Georgia-Tech-Off-Road/GTOR-DAQ/README.md

# GTOR-DAQ-Documentation
DAQ stuff! #rtfm
Main repository for Georgia Tech Offroad Data Aquisition ("GTOR DAQ").
