Georgia-Tech-Off-Road/GTOR-DAQ/Guides/SoftwareProposal.md

# New Software Proposal Form

# Software Details

## Overview

**Software Name:**

**Software Acronym:**

**Software Type (Utility/Library):**

## Goals
What are the objectives of this software? What will you do?

# Stages
Try to layout the development of this software as a series of projects. When/if this section is modified add the date of the modified stage as such:
Implement Fundemental System (rev. 06/23/2025)
