Georgia-Tech-Off-Road/GTOR-DAQ/01 New Member Information/09-25-2025 DAQ Meeting.pptx

## DAQ Meeting

## Agenda

- ADCs
- Strain Gauges
- PCB Design
- Testing
- Scripting Deployment
- Car wiring

## The Power of

Communication

## Overcoming

Nervousness

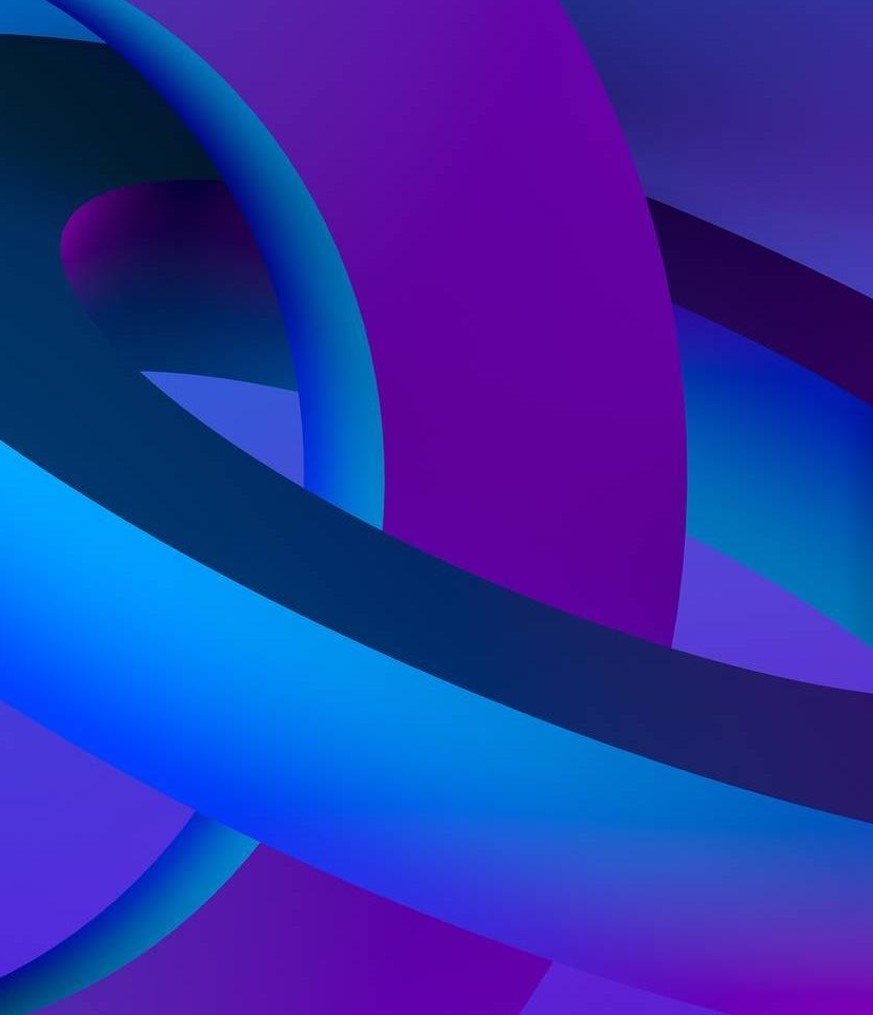
[picture p1: figure]
A blue and purple spirals

## Joseph & Colin

- sensor testing and validation

## Glenn & Kyle

Altium PCB design
- 1256 board, 2DREV12025

## Andrew

Strain Gauges / 1256 / PCB Design

## Alaric

1256 / Website / Test Class

## Dhruvith

Strain Gauges / Car Wiring

## DeadLines

Testing Class
- Tuesday 09/30/2025
Sensor Testing
- All hall effects and RPMs tested by 10/09/2025
1256 ADC
- Data recording by 10/02/2025
PCB Design Rev12025
- Rough draft 10/09/2025
- Use live polls or surveys to gather audience opinions, promoting engagement and making sure the audience feel involved

## DeadLines

PCB Design 1256 Board
- Rough draft 10/09/2025
Strain Gauges
- Have an operational strain gauge 10/09/2025

## SELECTING VISUAL AIDS

ENHANCING YOUR PRESENTATION

## Challenges

Time synchronization w Can / Data-Saving
Time Synchronization W XBees
Stable Voltage Supply
