Georgia-Tech-Off-Road/GTOR-DAQ/04 Sensors/Strain Gauge/Strain_Gauges.docx

# Strain Gauges

GT Off-Road Racing | Data Acquisition

Andrew Hellrigel

09/12/2021

# 1.0 Overview

## 1.1 Introduction

## 1.2 Point of Contact

Andrew Hellrigel (ahellrigel3@gatech.edu): Designed PCB for load cells

# 2.0 Strain Gauges

## 2.1 Strain Gauge Background

A strain gauge is an electromechanical device that changes in resistance when a strain is applied. When an external force is applied on an object, strain (tensile/compressive deformation in the shape of the object) occurs. Strain is defined as the change in length divided by the original length.

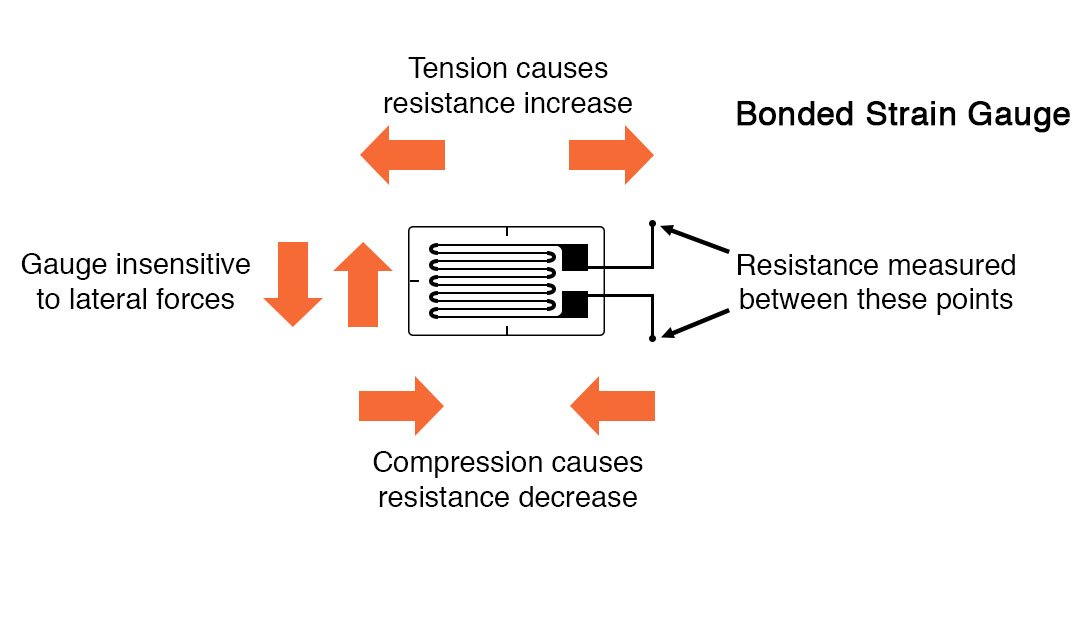
[picture p2: figure]
bonded strain gauge
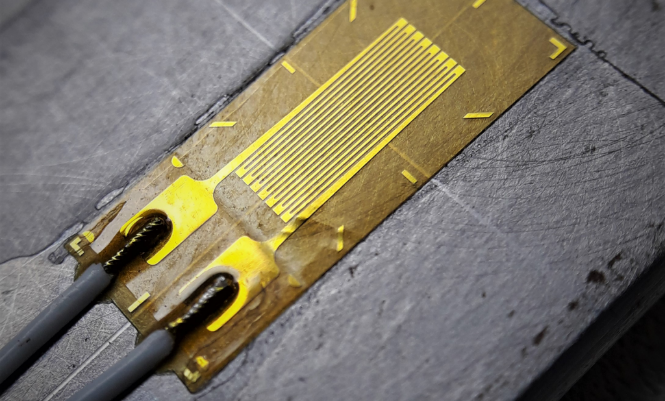
[picture p3: figure]
What is a Strain Gauge and How Does it Work? • Michigan Scientific

Figure 1 Forces measured by strain gauge | Figure 2 Strain gauge bonded to a test specimen

A strain gauges can be bonded to a test specimen (e.g. chassis tube). When the mechanical element has a force applied, the resulting strain can be measured at a specific point on the mechanical element.

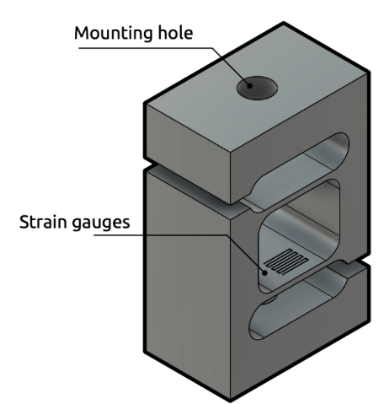
[picture p4: figure]
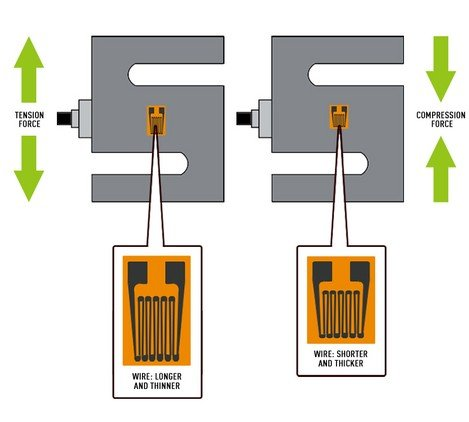
[picture p5: figure]
How Does a Strain Gauge Load Cell Work? | Load Cell Central
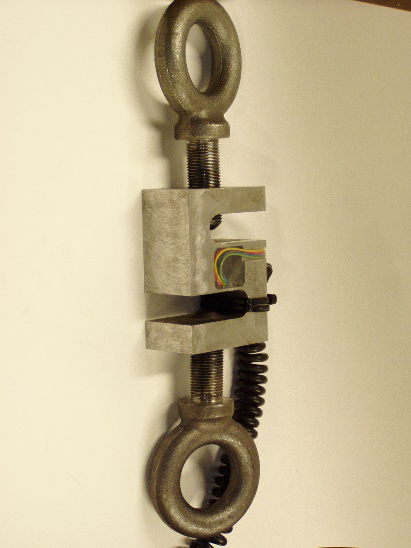
[picture p6: figure]
Load Cell Amplifier HX711 Breakout Hookup Guide - learn.sparkfun.com

Figure 3 S-type load cell 3D model | Figure 4 Forces measured by S-type load cell | Figure 5 S-type load cell mounted

A load cell is a transducer that measures force, and outputs this force as an electrical signal. For example, the S-type load cell pictured above measures tension and compression forces and can be mounted using the two threaded mounting holes on the top and bottom horizontals of the S.

# 3.0 Wheatstone Bridge

## 3.1 Wheatstone Bridge Circuit

### 3.1.1 Circuit Derivation

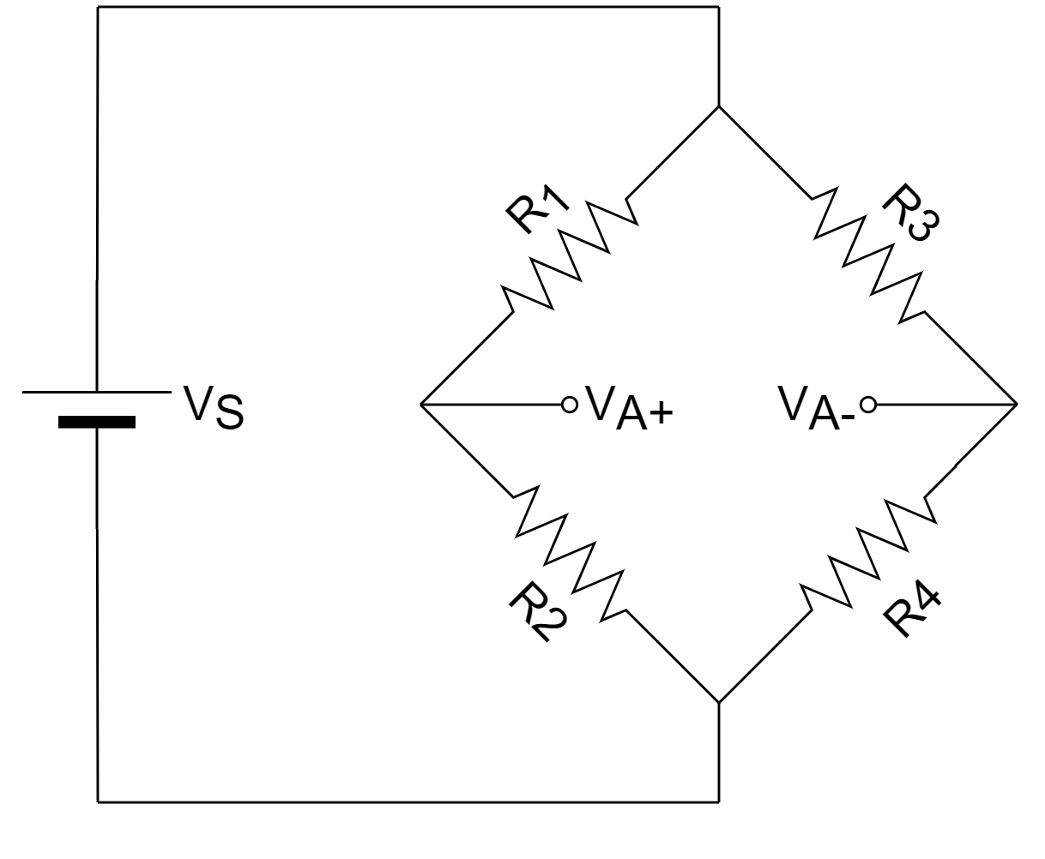
[picture p7: figure]

Figure 6 Wheatstone Bridge Circuit

A Wheatstone bridge is comprised of two voltage dividers in parallel. As such, the formulae for the node voltages are as follows:

V_(A+) =V_S *(R_1)/(R_1 +R_2) V_(A-) =V_S *(R_4)/(R_3 +R_4) V_(out) =V_(A+) -V_(A-)

V_(A+) and V_(A-) are derived from the voltage divider formula. V_(out) is the voltage difference between the A+ and A- nodes. V_(out) is proportional to the resistance variation of the resistors, R1, R2, R3, and R4. For example, if R1=R2=R3=R4, then VA+=VA-. As a result, Vout = 0. When the value of any resistor is changed, then the voltage difference Vout will change.

### 3.1.2 Swapping Resistors For Strain Gauges

The components for R1, R2, R3, and R4 can be normal resistors, or can be selectively replaced by a strain gauge (variable resistor based on strain). Using a strain gauge will allow Vout to increase/decrease based on the amount of strain on the test specimen.

## 3.2 Wheatstone Bridge Configurations

Table 1 Wheatstone Bridge Configurations

Configuration | Number of strain gauges | Number of resistors
Quarter-bridge | 1 | 3
Half-bridge | 2 | 2
Full-bridge | 4 | 0

### 3.2.1 Quarter-Bridge Strain Gauge Input

A quarter bridge strain gauge input is the simplest configuration that can be used. The resistive strain gauge is attached to the inputs on connector J1 to pins 5V and A+, and R1 is omitted from the PCB assembly. R2-R4 will be added to the PCB to complete the strain gauge.

### 3.2.2 Half-Bridge Strain Gauge Input

A half bridge strain gauge can also be connected to this circuit. The main advantage of a half-bridge strain gauges is that it compensates for changes in temperature.

### 3.2.3 Full-Bridge Strain Gauge Input

By omitting R1-R4, a full-bridge strain gauge can be connected directly to this circuit (this is the case for standard load cells that buy from Omega).

https://www.transducertechniques.com/wheatstone-bridge.aspx

# 4.0 Hardware Reference

## 4.1 Schematic (Input)

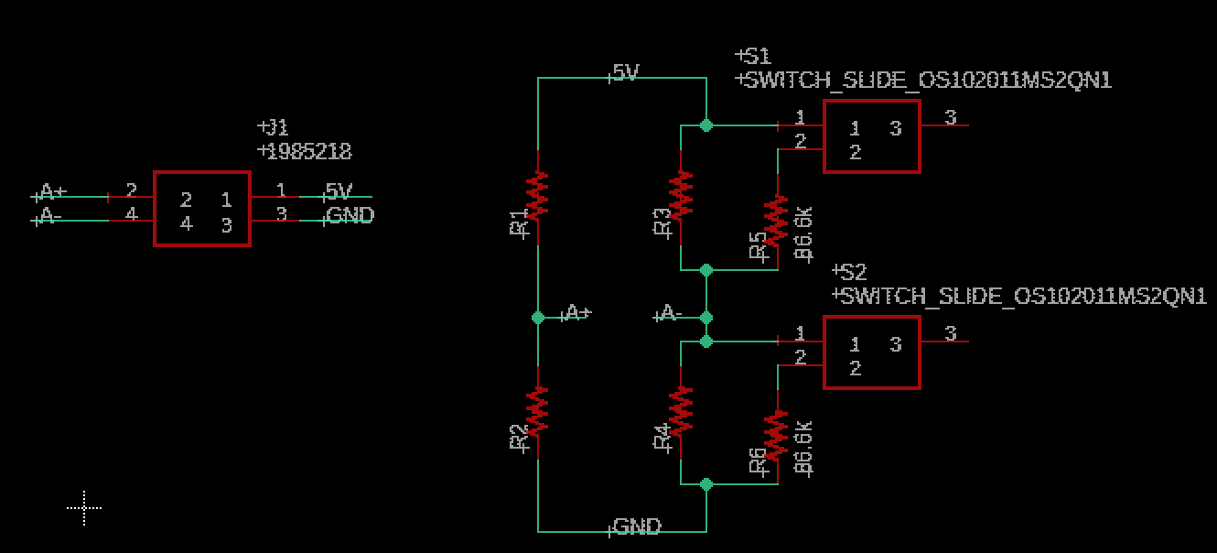
[picture p8: figure]

Figure 7

The above section of the schematic is the input along with the Wheatstone bridge. A Wheatstone bridge is a circuit that converts a change in resistance to a differential change in voltage between A+ and A-. R1-R4 are the bridge completion resistors.

### 4.1.1 Quarter-Bridge Strain Gauge Configuration

Attach a resistive strain gauge to the input pins, 5V and A+, on connector J1 to pins 5V and A+, and R1 is omitted from the PCB assembly. R2-R4 will be added to the PCB to complete the strain gauge.

### 4.1.2 Half-Bridge Strain Gauge Configuration

A half bridge strain gauge can also be connected to this circuit. The main advantage of a half-bridge strain gauges is that it compensates for changes in temperature.

### 4.1.3 Full-Bridge Strain Gauge Configuration

By omitting R1-R4, a full-bridge strain gauge can be connected directly to this circuit (this is the case for standard load cells that buy from Omega).

### 4.1.4 Output Signal Gain

R9 is the gain setting resistor for the amplifier. This resistor used should be as exact as possible. However, fi that’s not possible, use a higher resistance as opposed to a lower resistance if the difference is equal.

### 4.1.5 Calibration

R5-R6 are calibration resistors. When the slide switches are activated, they create a parallel voltage divider, decreasing the resistance of either R3 or R4 by a small amount. This, in effect, is emulating a change in resistance due to measured strain, however the exact change in resistance will be known. The actual change in measured strain can be divided against the expected change in measured strain to find a calibration factor that will calibrate against and variances in the tolerances of the electrical components used. Since there are two calibration resistors, this process can be done in both tension and compression.

This method of calibration is called shunt calibration, and this video does a decent job of explaining what that is. https://www.youtube.com/watch?v=w3RPWzUlq_Y

## 4.2 Schematic (Output)

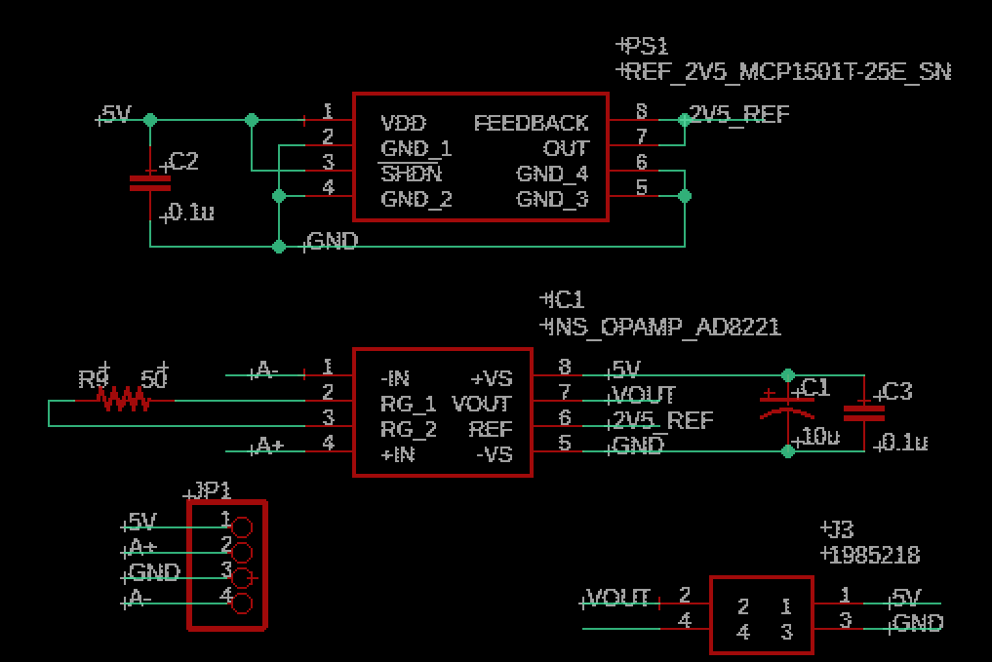
[picture p9: figure]

Figure 8

This portion of the schematic is the output section. It includes a voltage reference along with an instrumentation amplifier for amplifying the differential voltage generated by the Wheatstone bridge.

JP1 can be used as direct connections to the Wheatstone bridge so that you can bypass the amplifier stage if you want to use an HX711 or a Qwiic Scale as the load cell amp. The J3 connector directly outputs the analog voltage after the amplifier stage that can be fed directly into an ADC.

## 4.3 PCB

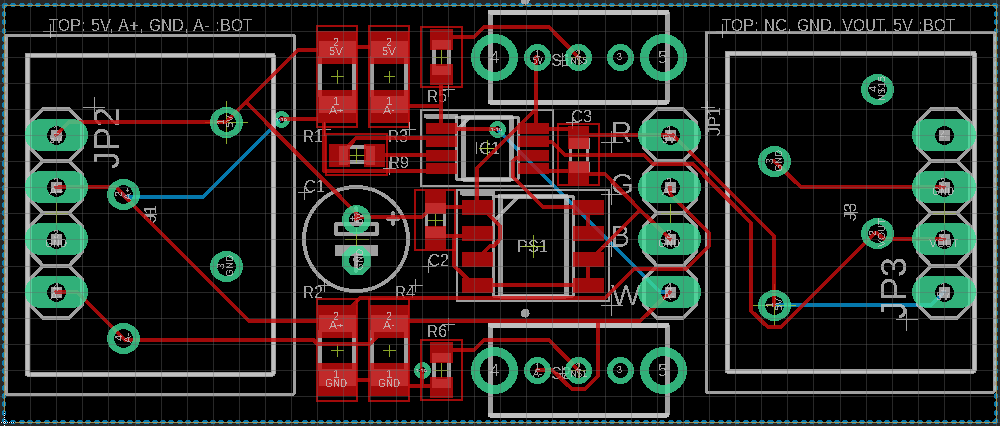
[picture p10: figure]

Figure 9

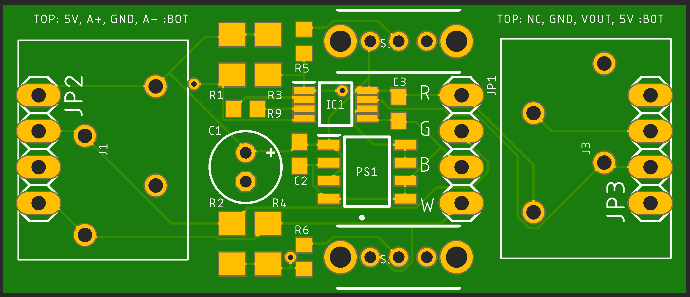
[picture p11: figure]

Figure 10

The PCB has a connection on the left for the strain gauge input and a connection on the right for the power and the voltage signal output. The PCB is configurable to many different input and output modes. The common modes it will be used in and the components that are needed for those modes are outlined below. R9 is the gain setting resistor.

### 4.3.1 Single Strain Gauge Input, Voltage Output

This mode is useful for measuring the strain of any component (such as a chassis member). If the board is being wired into the aux daq unit, then it will be useful to solder on the terminal blocks (J1, J3) so that wires can be easily plugged into the board. The wires from the strain gauge will plug into the left terminal block at the 5V output and the A+ output. This will make the strain gauge R1 in the Wheatstone bridge. Bridge completion resistors will need to be used for R2-R4.

If the strain gauge amplifier is being used for a specific application, it may be desirable to plug the strain gauge amplifier board directly into the PCB for the application it is being used for. In this case, the right terminal block can be omitted, and instead, headers can be used so that it can be plugged directly into a board. JP3 is where the power input and voltage signal output can be connected to the PCB. JP2 can also be used to connect to the board, but it is recommended to wire the strain gauge into the terminal block J1. The JP2 headers in the situation will be purely used for mechanical support.

It is recommended to wire the output voltage signal into an ADS8332 ADC (this is what is used for the 2022 aux daq design).

### 4.3.2 Single Strain Gauge Input, Full-Bridge Output

The single strain gauge input, full-bridge output configuration is what can be used to measure a single strain gauge with a load cell amp such as the Sparkfun QwiicScale or the HX711 load cell amplifier. These two load cell amps are designed to measure a load cell directly which already has a full bridge of strain gauges. However, with a single strain gauge and the amplifier board, bridge completion resistors (R2-R4) can be added so that it will behave like a load cell and a load cell amp can be used to measure it. The terminal block J1 can be added to wire in the strain gauge, and the output of the full bridge will come from JP1 and the outputs can be connected directly to a Sparkfun QwiicScale or an HX711. The colors at the output of the strain gauge amplifier board should match the color inputs for the Sparkfun QwiicScale.

### 4.3.3 Load Cell Input, Voltage Output

This board can be used as a full bridge load cell amplifier as well. In this case, J1 can be added and the load cell can be directly wired into 5V, A+, GND, A-. Some datasheets use O+ and O- for the load cell outputs, but this is the same as A+ and A-. If this is used, then no bridge completion resistors need to be added. The J3 terminal block can be added if this will be wired into the aux daq, or like the single strain gauge input, voltage output case, if it is being used for a specific application, the JP3 and JP2 pin headers can be used so that it can be connected directly to a PCB.

## 4.4 Wiring

# 5.0 Software Theory Of Operation

## 5.1 Amplification Calculations

There are 2 distinct stages for strain gauge / load cell measurements. The first is the Wheatstone bridge where the change in resistance of the Wheatstone bridge is converted to a differential voltage that can be amplified and then measured. The general strain gauge video https://www.youtube.com/watch?v=lWFiKMSB_4M does a good job of explaining how this works.

For load cells, this conversion is given in the data sheet. It is generally called the full scale voltage output or electrical output and it is a gain factor given as a certain number of mV/V. So for example, given this 500lb load cell from Omega, https://www.omega.com/en-us/force-strain-measurement/load-cells/p/LC103B, it gives the electrical output at 3mV/V. For the amplification board the input voltage is 5V, which means over the full-scale range of the output it will go from -15mV to 15mV (since it measures in both tension and compression). Since it measures from -500lbs to 500lbs a simple division can give us the conversion factor of 33.3lbs/mV. This means that for every 33.3lbs that is applied to the load cell, the difference in the output voltage (between A+ and A-) will change by 1mV.

The REF pin of the AD8221 instrumentation amplifier offsets the output by 2.5V so that the output never goes negative. If an exact resistor for R_(gain) cannot be obtained, try to use a resistor with a slightly larger resistance to keep the max/min force values within the voltage measuring range.

For strain gauges, this calculation is a little bit more complex. Strain gauges have two important values in the datasheet, the resistance and the gauge factor. The first seven pages of this manual, http://elektron.pol.lublin.pl/elekp/ap_notes/ni_an078_strain_gauge_meas.pdf, outline the calculations that can be used to calculate the voltage gain with respect to applied strain.

Formula | Description
GF=(∆R/R)/(∆L/L)=(∆R/R)/ε | Gauge factor
(∆R)/R | Fractional change in resistance
(∆L)/L=ε | Strain (fractional change in length)
R_(gauge) | Strain gauge resistance
R_(bc) | Bridge completion resistor resistance
R_(gain) | Amplifier gain setting resistor resistance
V_(exc) =5V | Excitation/source voltage
V_r =(change in V_(diff))/(volt of excitation) | Load cell or strain gauge electrical output ratio
V_(offset) =2.5V | Instrumentation amplifier voltage offset
G=(49.4k+R_(gain))/(R_(gain)) | Instrumentation amplifier gain
V_(out) =G(V_(diff) )=G(V^(+) -V^(-) ) | Voltage output from strain gauge PCB

### 5.1.1 SGT-3N/350-TY11 Strain Gauge (Quarter-Bridge)

https://www.omega.com/en-us/force-strain-measurement/strain-gauges/linear-strain-gauges/sgt-uniaxial/p/SGT-3N-350-TY11

https://www.amazon.com/DAOKI-BF350-3AA-High-Precision-Pressure-Resistance/dp/B07X87CJD8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

GF=2.0, ε_(max) =30000 μm, R_(gauge,unstrained) =350Ω

The bridge completion resistances should match the strain gauge resistance.

R_(bc) =R_(gauge,unstrained) =350Ω

Starting with calculating the maximum percent change in resistance of the strain gauge based on its specifications:

(∆R_(gauge))/(R_(gauge))|_(max) = ε_(max) *GF=6.0%

Next, the maximum and minimum resistance of the strain gauge:

∆R_(gauge) |_(max) =R_(gauge,unstrained) *(∆R_(gauge))/(R_(gauge))|_(max) =21Ω

R_(gauge,max) =R_(gauge,unstrained) +∆R_(gauge) |_(max) =371Ω

R_(gauge,min) =R_(gauge,unstrained) -∆R_(gauge) |_(max) =329Ω

Next, we calculate the maximum change in the raw output voltage from the Wheatstone bridge in both compression (strain gauge at minimum resistance) and tension (strain gauge at maximum resistance). Although V_(diff) can be positive or negative (centered at 0V), the instrumentation amplifier automatically adds a 2.5V offset to prevent negative voltages.

V_(A+) =V_(exc) *(R_(bc))/(R_(bc) +R_(gauge,strained)) , V_(A-) =V_(exc) *(R_(bc))/(R_(bc) +R_(bc))=1/2V_(exc)

V_(diff) =V_(A+) -V_(A-)

ΔV_(compression,max) =|V_(exc) ((R_(bc))/(R_(bc) +R_(gauge,min))-1/2)|=0.0773V

ΔV_(tension,max) =|V_(exc) ((R_(bc))/(R_(bc) +R_(gauge,max))-1/2)|=0.0728V

V_(diff,range) =[2.5-ΔV_(tension,max) ,2.5+ΔV_(compression,max) ]=[2.472, 2.5773]V

The largest change in voltage is used to calculate the gain G for the instrumentation amplifier. This gain is required to scale the raw output voltage to range from 0V to 5V to increase the resolution of the measurements measured by the ADC.

V_(diff,max) =max(ΔV_(compression,max) , ΔV_(tension,max) )=0.0773V

G=(V_(offset))/(V_(diff,max))=32.333

V_(out) =[G*V_(diff,max) -V_(offset) , G*V_(diff,max) +V_(offset) ]=[0, 5]V

Based on the AD8221 instrumentation amplifier datasheet, the formula for calculating the gain setting resistor is:

R_(gain) =(49.4kΩ)/(G-1)=1.58kΩ

See code in “Strain Gauges” folder to calculate these values automatically (specifically for this PCB design) in the “calc_quarter_bridge_gain.m” file.

### 5.1.2 LC103B-500 Load Cell

https://www.omega.com/en-us/force-strain-measurement/load-cells/p/LC103B

For this 500lb load cell from Omega, the electrical output is 3mV/V. For every 1V of the power supply voltage, the output range will increase by 3mV. For the amplification board the input voltage is 5V, which means over the full-scale range of the output it will go from -15mV to 15mV (since it measures in both tension and compression). Therefore, we must set the gain to stretch the range to 0V to 5V when offset by 2.5V.

V_r =3(mV)/V

V_(diff) =V_(exc) *V_r =[-15, 15]mV

G=(V_(offset))/(V_(diff,max))=(2.5V)/(15mV)=166.67

R_(gain) =(49.4kΩ)/(G-1)=296.4Ω

V_(out) =(G*V_(diff) )+V_(offset) =[0, 5]V

~~Since it measures from -500lbs to 500lbs a simple division can give us the conversion factor of 33.3lbs/mV. This means that for every 33.3lbs that is applied to the load cell, the difference in the output voltage (between A+ and A-) will change by 1mV.~~

## 5.2 Calibration Routine

# 6.0 References

## 6.1 YouTube Videos

General strain gauges - https://www.youtube.com/watch?v=lWFiKMSB_4M

Strain gauge installation - https://www.youtube.com/watch?v=s4Bq8MvwbyU

Shunt calibration - https://www.youtube.com/watch?v=w3RPWzUlq_Y

## 6.2 Websites

Shunt calibration - https://www.me-systeme.de/en/technology-first/strain-gauge/Shunt-calibration

Sparkfun QwiicScale Tutorial - https://learn.sparkfun.com/tutorials/qwiic-scale-hookup-guide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

HX711 - https://www.sparkfun.com/products/13879

500 lb Load Cell from Omega - https://www.omega.com/en-us/force-strain-measurement/load-cells/p/LC103B

Strain gauge calculations manual - http://elektron.pol.lublin.pl/elekp/ap_notes/ni_an078_strain_gauge_meas.pdf

Linear Strain Gauge from Omega - https://www.omega.com/en-us/force-strain-measurement/strain-gauges/linear-strain-gauges/sgt-uniaxial/p/SGT-3N-350-TY11

# 7.0 Revision History

2/1/2022 (Andrew Hellrigel) – Created first revision, still need to add documentation about wiring (the inputs and outputs to the board) and the calibration routine.
