Georgia-Tech-Off-Road/GTOR-DAQ/Guides/Electrical Project Proposal.md

## Why Does This Document Exist?
As electrical engineering projects require the aquisition and use of physical components their planning is a little different than that of software projects. Please use this form when submitting a proposal for such a project.

## Overview
What is this project? What's it for?

## Timeline
Your timeline should be seperated into ideation, research, aquisition, prototyping, testing, review, and final construction/deployment. You should have hard deadlines for ideation and research, but ordering can be highly variable, so prototying/testing should be formatted as final delivery received + x days. Review (a meeting with relevant leads involving a presenation of your project) should be denoted as testing + num shop nights needed to create presentation. Do not give a date for final construction/deployment until after review, as this will need to be as accurate as possible. 

## Outline of Implementation
What's your general idea? Write a paragraph or so about what exactly it is you're creating.

## Capabilities
What makes your project better than what we already have? List out important features you plan to include in the end product.

## Why?
Detail how this project will aid the team. Why are you doing this?

## Necessary Tools/Training
Do you need anything other than a soldering iron and some wire strippers? List out any non-standard skills/tools you need to make your idea a reality.

## Parts List
Make as detailed a parts list as you can manage right now. This will be updated as the project continues with any future annotations added in red, but try to give your leads a solid idea of what exactly you'll need to buy for this.

## Alternatives to this Project
What are alternatives to pursuing this project? If appropriate describe why you are not pursuing this alternative.

##   Sources
What evidence do you have to support your approach? Assemble a short list of projects/research (both GTOR, personal, and 3rd party examples are fine) that someone can use to gain a better understanding of your approach and reasoning.
