Georgia-Tech-Off-Road/GTOR-DAQ/05 DAQ Pack/OLD-DAQPackCode/README.md

This is old DAQPack code from before our simplification. Specifically this was taken from commit: 56806592f46b722d96a833f1e6c729c6b648210a. This contains useful teensy thread implementation.
