Georgia-Tech-Off-Road/GTOR-DAQ/01 New Member Information/Images/git-log-after-pull.png

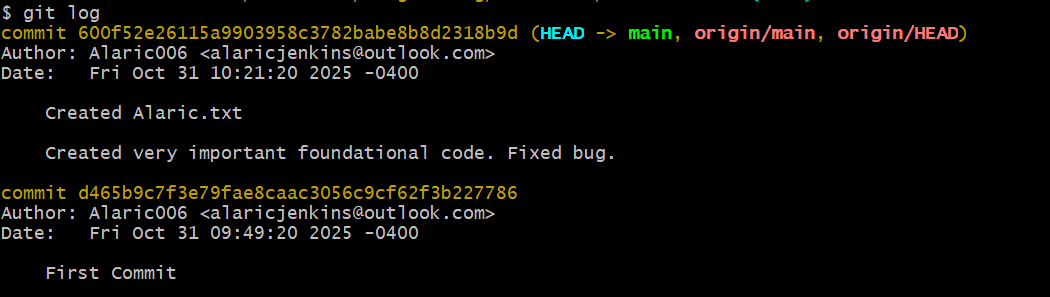
01 New Member Information/Images/git-log-after-pull.png
