Georgia-Tech-Off-Road/GTOR-DAQ/09 Inventory/GTOR Inventory.xlsm

Sheet: DAQ Inventory
GTOR | DAQ Inventory
Category | Name | Subtract | Quantity (must be #) | Add | Location | Part / ID # | Link
<= 100 Ω Resistors | 100 ohm |  | 10 |  | DAQ HQ Drawer R1
>100Ω<=500Ω | 150 ohm |  | 4 |  | DAQ HQ Drawer R1
 | 150 ohm |  | 4
 | 270 ohm |  | 9
>500Ω<=1kΩ | 1k ohm |  | 8 |  | DAQ HQ Drawer R1
>1kΩ<=5kΩ | 2k ohm |  | 7 |  | DAQ HQ Drawer R1
 | 3.3k ohm |  | 6
 | 4.6k ohm |  | 91
 | 4.7k ohm |  | 8
>5kΩ<=10kΩ | 5.1k ohm |  | 6 |  | DAQ HQ Drawer R1
 | 10k ohm |  | 3
>10kΩ<=50kΩ | 11k ohm |  | 2 |  | DAQ HQ Drawer R1
 | 46k ohm |  | 1 |  | DAQ HQ Drawer R1
 | 47k ohm |  | 2 |  | DAQ HQ Drawer R1
>50kΩ<=100kΩ | 91k ohm |  | 9 |  | DAQ HQ Drawer R1
 | 100k ohm |  | 27 |  | DAQ HQ Drawer R1
>100kΩ | 680k ohm |  | 10 |  | DAQ HQ Drawer R1
Misc Resistors |  |  |  |  | DAQ HQ Drawer R1
Mech. Pots | b10k pot. |  | 9 |  | DAQ HQ Drawer R2
 | Assorted mech. Pots. |  | 10
 | 4131104 |  | 6 |  |  | 4131104
 | 4131103 Digital |  | 4 |  |  | 4131103
Misc. Pots | Misc. Pots |  | 7 |  | DAQ HQ Drawer R2
Digital Pots |  |  |  |  | DAQ HQ Drawer R2
Transistors | Transistors |  | 0 |  | DAQ HQ Drawer R2
MOSFETs | MOSFETs |  | 0 |  | DAQ HQ Drawer R2
Relavs | Relavs |  | 4 |  | DAQ HQ Drawer R2
Buttons | Buttons |  | 9 |  | DAQ HQ Drawer R2
Capacitors |  |  |  |  | DAQ HQ Drawer R2
Diodes | Assorted |  | 66 |  | DAQ HQ Drawer R3
LEDs | 2-pin LED |  | 123 |  | DAQ HQ Drawer R3
 | 4-pin LED |  | 1
LED Arrays |  |  | 2 |  | DAQ HQ Drawer R3
Buzzers |  |  | 2 |  | DAQ HQ Drawer R3
Small Mech. Switch | 2-pin |  | 17 |  | DAQ HQ Drawer R3
 | 3-pin |  | 2
 | 4-pin |  | 23
Large Mech. Switch | 2-pin |  | 3 |  | DAQ HQ Drawer R3
 | 3-pin |  | 4
Alligator Clips | Alligator>9V adapter |  | 1 |  | DAQ HQ Drawer R3
 | Half broken clip |  | 1
Small Heatshrink | Small Heatshrink |  | A lot |  | DAQ HQ Drawer R4
Medium Heatshrink | Medium Heatshrink |  | Several |  | DAQ HQ Drawer R4
Large Heatshrink | Large Heatshrink |  | A lot |  | DAQ HQ Drawer R4
Small Zipties | Small Zipties |  | A lot |  | DAQ HQ Drawer R4
Markers & Pens | Markers & Pens |  | Enough |  | DAQ HQ Drawer R4
Female Headers | Female Headers |  | A lot |  | DAQ HQ Drawer R4
Male Headers | Male Headers |  | A lot |  | DAQ HQ Drawer R4
More Capacitors | Misc. unknown capacitors |  | n/a |  | DAQ HQ Drawer R5
Breadboards | Solder Breadboards |  | 8 |  | DAQ HQ Drawer R5
Solderless Breadboards | Solderless Breadboards |  | A lot |  | DAQ HQ Drawer R5
Microcontrollers | Teensy 4.1 |  | 8 |  | DAQ HQ Drawer R5
 | Teensy 3.6 |  | 2
 | Arduino Duemilanove |  | 1
 | Silver Coral |  | 2
 | 2560 Arduino Mega |  | 1
 | Arduino Mega |  | 1
 | Unknown Microprocessors |  | 5
 | C Studio Microprocessors |  | 3
 | Metro Mini |  | 1
M-F Jumpers | M-F Jumpers |  | Low |  | DAQ HQ Drawer R6
M-M Jumpers | M-M Jumpers |  | Very low |  | DAQ HQ Drawer R6
F-F Jumpers | F-F Jumpers |  | A lot |  | DAQ HQ Drawer R6
18 AWG | 18 AWG |  | Low |  | DAQ HQ Drawer R7
22 AWG | 22 AWG |  | A lot |  | DAQ HQ Drawer R7
Misc. Wire | Misc. Wire |  | A lot |  | DAQ HQ Drawer R7
Small Bags | Small Bags |  | Very low |  | DAQ HQ Drawer R7
IMUs | BNO05 ADAFRUIT BLUE |  | 2 |  | DAQ HQ Drawer R8
 | BNO05 ROBOT-ELEC.. GREEN |  | 1
 | SEN-13339 RED |  | 7
Accelerometers |  |  |  |  | DAQ HQ Drawer R8
Shift Resistors |  |  |  |  | DAQ HQ Drawer R8
ADCs & DACs | ADCs & DACs |  | 3 |  | DAQ HQ Drawer R8
Molex. Conn |  |  |  |  | DAQ HQ Drawer R8
Push-In Connector | 2x1 Green |  | 11 |  | DAQ HQ Drawer R8
 | 3x1 Green |  | 17
 | 4x1 Green |  | 3
 | 6x1 Black |  | 1
Butt Joints | 22-16 AWG RED |  | 6 |  | DAQ HQ Drawer R8
 | ??? BLUE |  | 1
Crimp Connector |  |  |  |  | DAQ HQ Drawer R8
Wireless |  |  |  |  | DAQ HQ Drawer R8
Bluetooth | Bluetooth |  | 1 |  | DAQ HQ Drawer R9
Logic Gates | 74F00PC- NAND |  | 7 |  | DAQ HQ Drawer R9
 | SNx4HC86 - XOR |  | 1
 | 74HCT04N - NOT |  | 1
 | CD4017BE - DECADE COUNTER |  | 1
Timers |  |  |  |  | DAQ HQ Drawer R9
TH Rubber | Rubber |  | A lot |  | DAQ HQ Drawer R9
TH Plastic | Plastic |  | A lot |  | DAQ HQ Drawer R9
JST Connectors | Male |  | 7 |  | DAQ HQ Drawer R9
 | Female |  | 5
Screw-in Connectors | ORANGE |  | 5 |  | DAQ HQ Drawer R9
 | CYAN |  | 6
 | SKY BLUE |  | 6
 | DARK BLUE |  | 1
 | GREEN |  | 3
Speed | Speed sensor |  | 2 |  | DAQ HQ Drawer R10
Distance | Distance sensor |  | 2 |  | DAQ HQ Drawer R10
Op Amps | TL071P |  | A lot |  | DAQ HQ Drawer R10 | TL071P
Voltage Reg. | Green Board |  | 6 |  | DAQ HQ Drawer R10
 | Key Thing |  | 6
 | Black THing |  | 1
TH Board Side | Board Side |  | A lot |  | DAQ HQ Drawer R10
TH Outer Side | Outer Side |  | A lot |  | DAQ HQ Drawer R10
Dean's Connector | Dean |  | A lot |  | DAQ HQ Drawer R10
Battery Connector | Battery Connector |  | 1 |  | DAQ HQ Drawer R10
Misc. Sensors | Temp Sensors |  | 5 |  | DAQ HQ Drawer R11
 | SEN-15242 |  | 2
 | SEN-13879 |  | 2
 | GREEN STUFF |  | 2
 | BLUE THING |  | 2
Memory Storage | MicroSD card 64gig |  | 1 |  | DAQ HQ Drawer R11
 | MicroSD to SD card adapter |  | 1
Misc. Ics | Various Ics |  | n/a |  | DAQ HQ Drawer R11
1.5V Battery | AA Battery |  | 0 |  | DAQ HQ Drawer R11
TH Other |  |  | 6 |  | DAQ HQ Drawer R11
TH O-Rings | Small |  | 19 |  | DAQ HQ Drawer R11
 | Medium |  | 5
 | Large |  | 6
Misc. | ???? |  | n/a |  | DAQ HQ Drawer R11
Misc. | Small Magnets |  | 33 |  | DAQ HQ Drawer R11
Motors | Small motor |  | 2 |  | DAQ HQ Drawer R12
 | Medium motor |  | 1
 | Single DC driver carrier |  | 1 |  |  | 0J9031
Misc. Batteries | 3V battery |  | 24 |  | DAQ HQ Drawer R12
 | 1.5V battery |  | 1
 | 3V duracell battery |  | 1
 | 5V USB power bank |  | 1
 | 5V battery thing? |  | 1
 | CR 2032 watch battery
 | 9.6V double-cell battery |  | 1
Solder Equipment | Flux pen |  | 4 |  | DAQ HQ Drawer R12
 | Magnifying glass |  | 1
 | Tweezer |  | 1
 | Chip extractor |  | 1
 | Clip head |  | 1
 | Screw bolt |  | 1
Solder & Big Zipties | Cable Ziptie |  | 175 |  | DAQ HQ Drawer R12
USB Cables | A-C Adapter cable |  | 1 |  | DAQ HQ Drawer R13
 | A-C Adapter |  | 4
 | A-B Adapter |  | 2
Other Cables | Locking cable??? |  | 1 |  | DAQ HQ Drawer R13
 | A to MicroUSB cable |  | 1
 | A to barrel adapter |  | 1
Test Leads | Small red piece |  | 2 |  | DAQ HQ Drawer R13
 | Small black piece |  | 2
 | Black piece, flat end??? |  | 2
 | Red adapter |  | 1
 | Black adapter |  | 1
 | Power supply lead |  | 1
 | Red alligator clip end |  | 1
 | Black alligator clip end |  | 1
Tape | Teflon tape roll |  | 4.5 |  | DAQ HQ Drawer R13
 | Electrical tape roll |  | 1.1
 | Scotch tape roll |  | 1
 | PFTE tape |  | 0.5
Misc. Hardware | Screw clamp |  | 1 |  | DAQ HQ Drawer R14
 | Large nuts |  | 2
 | Octagon nut thing? |  | 1
 | Small screwable hook |  | 2
 | Misc. small nuts |  | Several
 | Misc. screws |  | Several
Misc. ????? | ???? |  | n/a |  | DAQ HQ Drawer R14
Cutters & Pliers | Scalple |  | 1 |  | DAQ HQ Drawer R14
 | Needle-nose plier |  | 1
 | Normal plier |  | 1
Small Screwdrivers | Phillips head |  | 2 |  | DAQ HQ Drawer R14
 | Flathead |  | 1
 | Torque |  | 1
Wire Spools | Red wire spool |  | 2 |  | DAQ HQ Drawer
 | White wire spool |  | 1
 | Large wire spool |  | 2
Misc. Mechanical | Instant Adhesive |  | 2 |  | DAQ HQ Containers
 | Anti-static Tweezer |  | 7
 | Ball Bearings |  | 6
 | Washer |  | ~80 |  |  | B-0125A2M3.2-B100
 | Button socket cap |  | 100
 | ~2in standoffs |  | 6
 | Flat tool with holes at ends |  | 2
 | Big black thing?????? |  | 1
Misc. Sensors | Fuzzy tape roll |  | 1 |  | DAQ HQ Containers
 | Velcro tape roll |  | 1.75
 | Electrical tape roll |  | 1
 | Analog sensor |  | 1 |  |  | 296-47666-1-ND
 | Hall effect sensor |  | 1
 | LDS |  | 1
 | Rotary encoder |  | 1
Misc. parts | CMC WR Cap |  | 3 |  | DAQ HQ Containers | WM4251-ND
 | Conn. RCPT HSG |  | 2 |  |  | WM4527-ND
 | Conn. Header brd. Edge |  | 2 |  |  | WM13375-ND
 | Car Wires |  | 2
 | 25kg digital servo |  | 1
 | AuxDac breakout board |  | 2
 | AuxDac base board |  | 2
 | RES SMD 350ohm |  | 1 |  |  | 1135-1695-1-ND
 | LED Strip |  | 4
 | Capacitor CER 0.1UF |  | 100 |  |  | 399-C0603C104K4RAC7082CT-ND
 | RES 4.9ohm |  | 95 |  |  | RMCF0603FT49R9CT-ND
 | Switch slide SPDT 12V |  | 4 |  |  | CKN9565-ND
 | Teflon tape roll |  | 1
 | Capacitor alum. 10UF 25V |  | 6 |  |  | 732-8820-1-ND
Radio | Radio connector cable |  | 1 |  | DAQ HQ Containers
Misc resistors/capacitors | SMD Resistor strips |  | A lot |  | DAQ HQ Containers
Capacitors, Resistors | Empty bags? |  | A lot |  | DAQ HQ Containers
 | 440 V BLUE capacitors |  | 5
 | 450 V 4.7 microfarads capacitor |  | 2
 | 400 V 2.2 microfarad BROWN capacitor |  | 1
 | 2000 V ??? MAROON capacitor |  | 1
 | DARK YELLOW capacitor 14N681K capacitor |  | 1
 | B 681 SMALL ORANGE YELLOW |  | 1
 | 450 V capacitor blue / black |  | 2
 | 50 V 10 microfarad black |  | 1
 | 275 V~x2 0.68 microfarad yellow |  | 1
 | Yellow rectangles? |  | 4
Misc. Toolbox | Radio contact button |  | 1 |  | Misc. Toolbox
 | Tan connector? |  | 3
 | Other tan connector |  | 9
 | 3-pin molex (female) |  | 7
 | 4-pin molex (f) |  | 10
 | 6-pin molex (f) |  | 10
 | Kill switch |  | 4
 | Conn. ferrule din 22awg |  | 175 |  |  | A136908-ND
 | Orthodontic elastics |  | 70
 | 3-way automotive connectors |  | 6
 | Brake pressure sensor (diff. types) |  | 5
 | Very small silver connectors? |  | 25
 | Small silver connectors (in strips) |  | 49
 | Medium silver connectors (in strips) |  | 59
 | 3-pin molex cable |  | 1
Weatherpack | Conn. Socket 22-24AWG |  | 115 |  | Weatherpack Toolbox | WM14361CT-ND
 | Lights with wires, 1r,1b,1y,1g,1w |  | 1
 | Blue weatherpack connector |  | 50
 | Green weatherpack connector |  | 5
 | Sm Connector pins |  | Several
 | Md Connector Pins |  | 17
 | L Connector pins |  | A lot
 | XL Connector pins |  | 17
 | Black thing ??????? |  | 8
 | Terminal release tool |  | 1
 | Black marker |  | 1
Standard Hardware | 1/4in flat washer |  | 12 |  | Standard Hardware Toolbox
 | Servo consistency master |  | 3
 | 25kg coreless digital servo |  | 1
 | CGRobot Sensor |  | 1
 | Screw clamp |  | 1
 | Small blue computer chip? |  | 3
 | 3/8" NPT Black screw thing? |  | 1 |  |  | CD09NR-BK-N-O
 | NEO-6m Flight controller module |  | 1
 | 1/4in medium screw |  | A lot
 | 1/4in long screw |  | A lot
 | 1/4in nuts |  | 49
 | Wired/assembled flight controller module |  | 2
Metric Hardware | .7x20 12.9 socket screw |  | 22
 | 1/4in-20 lock nuts |  | 50
 | Small? Nuts |  | 75
 | DIN 985 M4 lock nuts |  | 32
 | DIN 985 M3 lock nuts |  | 95
 | 2-28x3/8 screw |  | 25
 | .8x20mm screw |  | 80
 | 40x40/40 socket screw |  | 10
 | Various washers |  | n/a
 | 25mm screw |  | 8
 | 50mm screw |  | 17
 | Pin removal tools (keychain) |  | 1
Sensor | Omega rotary toqrue sensor |  | 1 |  | Daq HQ Aux/Daq box
Andrew's Misc Box Stuff | Andrew's testing board |  | 1 |  | Andrew's Cool Box
 | Empty spool. Why, Andrew? |  | 1
 | USB A to B adapter |  | 1
Pliers, Crimpers, Etc. | Wire stripper |  | 6 |  | Toolbag
 | Needle nose plier |  | 1
 | Small standard plier |  | 3
 | Crimper |  | 4
 | Lighter |  | 1
 | Black marker |  | 4
 | Digital caliper |  | 1
 | Electrical tape roll |  | 1
 | Heat shrink tubing kit |  | 2 |  | Red Toolbox w/ wheels
 | AA battery |  | 14
 | LX-770 soldering kit |  | 1
 | Wire stripper |  | 1
 | Needle nose plier |  | 1
 | Black marker |  | 2
 | Crimper |  | 1
 | Curved jaw plier |  | 1
 | Electric heat gun |  | 1
 | Mini electric heat gun |  | 1
 | Socket head cap screw set |  | 1
 | 28A battery |  | 2
 | Red wire spool |  | 1
 | Black wire spool |  | 0.5
 | Button |  | 1
 | AAA battery |  | 39
 | 9V battery |  | 8
 | Hex key set |  | 1
 | 18 gauge wire spool |  | 2
 | Digital tachometer |  | 1
 | Solderer |  | 1
 | Precision screwdriver set |  | 1
 | Red light |  | 2
 | Butane fuel canister |  | 2.25
 | Weird battery charger kit |  | 1
 | Thick gray wire bundle |  | 1
 | Thin gray wire spool |  | 2
 | 6.4gb miscroSD card |  | 2
 | MicroSD card adapter |  | 1
 | MicroSD card USB adapter |  | 2
 | Soldering wick spool |  | 0.75

Sheet: Manufacturing Inventory
GTOR | Carts
Category | Name | Subtract | Quantity (must be #) | Add | Location | Part / ID # | Link
 | Turbine Oil |  | 0.2 |  | Blue Cart

Sheet: Cart Inventory
GTOR | Carts
Category | Name | Subtract | Quantity (must be #) | Add | Location | Part / ID # | Link
 | Turbine Oil |  | 0.2 |  | Blue Cart
Telescoping Gauge | Telescoping gauge set |  | 1
 | Sm flat tip screwdriver |  | 1
 | Large flat tip screwdriver |  | 1
 | Lg file |  | 3
 | Sm clamp |  | 3
 | Md clamp |  | 3
 | Lg clamp |  | 2
 | Lg socket wrench |  | 1
 | Caliper |  | 1
 | 250mm wrench |  | 1
 | Allen wrench set |  | 2
 | Cutting fluid gallon |  | 0.5 |  | Blue cart, bottom shelf
Rot. Drill bits | #6 82deg |  | 1 |  | Blue cart, md. red case
 | #5 |  | 1
 | #4 |  | 1
 | #4 |  | 1
 | Sm. #2 drill bit |  | 1 |  | Blue cart, sm. red case
 | Sm. #3 drill bit |  | 2
 | Interapid test indicator set |  | 1 |  | Blue cart, lg. red case
 | Fancy digital caliper |  | 2 |  | Blue cart
 | Protractor/ruler thing? |  | 1
 | T20 torx screwdriver |  | 1
 | T15 torx screwdriver |  | 1
 | ? torque screwdriver |  | 1
 | 1/8 x 1 x 6 1/2 tool block |  | 1 |  |  | SGTBN19-5
 | Sm. Mystery tool block |  | 1
 | Md. Mystery tool block |  | 1
 | Lg. Mystery tool block |  | 1
 | Lg. socket head cap screw |  | 1
 | Md. socket head cap screw |  | 1
