Georgia-Tech-Off-Road/GTOR-DAQ/04 Sensors/Strain Gauge/Strain_Gauges_BoM.xlsx

Sheet: Sheet1
Product Number | Description | Unit price | Qty. | Total | Vendor | Link | Column3 | Column4 | Column5 | Column6 | Column7 | Column8 | Column9 | Column10 | Column11 | Column12 | Column13 | Column14 | Column15 | Column16 | Column17 | Column18 | Column19 | Column20 | Column21 | Column22 | Column23 | Column24 | Column25 | Column26 | Column27 | Column28 | Column29 | Column30 | Column31 | Column32 | Column33 | Column34 | Column35 | Column36 | Column37 | Column38 | Column39 | Column40 | Column41 | Column42 | Column43 | Column44 | Column45 | Column46 | Column47 | Column48 | Column49 | Column50 | Column51 | Column52 | Column53 | Column54 | Column55
JLCPCB | Slip Sensor PCB | -- | 25 | $9.92
 | 10 uF capacitor | $0.33 | 15 | $4.95
 | 0.1 uF capictor | $0.11 | 15 | $1.65
 | 4.7 uF capacitor | $0.29 | 15 | $4.35
 | Teensy 4.0 | $21.88 | 1 | $21.88
 | Slip Sensor | $12.00 | 10 | $120.00
 | Hello |  |  | $0.00
 |  |  |  | $0.00
 |  |  |  | $0.00
 | asdfad |  |  | $0.00
 |  |  |  | $0.00
 |  |  |  | $0.00
 |  |  |  | $0.00
 |  |  |  | $0.00

Sheet: Sheet2
Vendor Name | Item URL | Item/Part Number | Item Description | Quantity | Unit Price | Total Price | Notes
Amazon | https://www.amazon.com/Amazon-Brand-Isopropyl-Antiseptic-Technical/dp/B07NFSFBXQ?s=industrial | n/a | Isapropyl alcohol | 1 | $6.99 | $6.99
Amazon | https://www.amazon.com/Eternal-Professional-Nail-Polish-Remover/dp/B07PWHN5K6 | n/a | Acetone | 1 | $8.99 | $8.99
Amazon | https://www.amazon.com/Sandpaper-Assortment-Automotive-Furniture-Finishing/dp/B01K22Q9R8?s=industrial | n/a | Sandpaper | 1 | $8.99 | $8.99
Amazon | https://www.amazon.com/Venom-Chemical-Resistant-Disposable-Nitrile-Gloves/dp/B094P17WJS?s=industrial | n/a | Nitrile gloves | 1 | $19.99 | $19.99
Amazon | https://www.amazon.com/Kimtech-Science-Wipes-Kimwipes-KCC34155-06/dp/B00C1K7Y74?s=industrial | n/a | Kimtech Wipes | 1 | $17.97 | $17.97
Amazon | https://www.amazon.com/Seahorse-Medium-Tactical-Case-Black/dp/B071R3MVH7 | n/a | Protective foam case | 1 | $27.78 | $27.78
Amazon | https://www.amazon.com/Scotch-Standard-Engineered-Office-810K2/dp/B00DFYH5QA | n/a | Cellophane Tape | 1 | $6.49 | $6.49
Amazon | https://www.amazon.com/Precision-Anti-Static-Electronics-Sodlering%EF%BC%8CJewelry-Laboratory/dp/B07ZBZ7MSF | n/a | Tweezers | 1 | $6.49 | $6.49
Amazon | https://www.amazon.com/Pack-Tungsten-Carbide-Scriber-Magnet/dp/B0789HX8LC | n/a | Scribes | 1 | $9.88 | $9.88
Amazon | https://www.amazon.com/Inches-Plumbers-Plumbing-Plumber-Sealing/dp/B091913Z7F | n/a | Teflon tape | 1 | $5.99 | $5.99
Amazon | https://www.amazon.com/MG-Chemicals-Flux-Soldering-Amber/dp/B077GVRMZQ | n/a | Flux pen | 1 | $14.95 | $14.95
Amazon | https://www.amazon.com/DAOKI-BF350-3AA-High-Precision-Pressure-Resistance/dp/B07X87CJD8 | n/a | 10 Linear stain gauges | 2 | $9.99 | $19.98
Digikey | https://www.digikey.com/en/products/detail/analog-devices-inc/AD8221ARMZ-R7/996058 | AD8221ARMZ-R7CT-ND | AD8221 instrumentation amplifier | 4 | $6.40 | $25.60 | PS1
Digikey | https://www.digikey.com/en/products/detail/phoenix-contact/1985218/568661 | 277-1624-ND | Phoenix contact 4 input 45 deg terminal block | 10 | $0.59 | $5.87 | J1, J3
Digikey | https://www.digikey.com/en/products/detail/vishay-dale/D55342E07B350ART5/3197959 | 1135-1695-1-ND | 350 Ohm 0.1% bridge completion resistors | 10 | $3.80 | $38.00 | R1-R4
Digikey | https://www.digikey.com/en/products/detail/w%C3%BCrth-elektronik/860020472003/5728765 | 732-8820-1-ND | 10uF 25V Aluminum Electrolytic Capacitor | 10 | $0.10 | $1.00 | C1
Digikey | https://www.digikey.com/en/products/detail/samsung-electro-mechanics/CL10B104KA8NNNC/3886664 | 1276-1006-1-ND | 0.1uF 25V Ceramic Capacitor | 100 | $0.01 | $1.26 | C2-C3
Digikey | https://www.digikey.com/en/products/detail/stackpole-electronics-inc/RMCF0603FT49R9/1760879 | RMCF0603FT49R9CT-ND | 49.9 Ohm 1% 0603 Resistor | 100 | $0.01 | $0.68 | R9 (can be other values to set gain)
Digikey | https://www.digikey.com/en/products/detail/microchip-technology/MCP1501T-25E-SN/5864123 | MCP1501T-25E/SNCT-ND | 2.5V Shunt Voltage reference | 5 | $0.93 | $4.65 | IC1
Digikey | https://www.digikey.com/en/products/detail/panasonic-electronic-components/ERJ-PB3B8662V/6212976 | P20193CT-ND | 86.6k 0.1% shunt resistor | 25 | $0.14 | $3.48 | R5-R6
Digikey | https://www.digikey.com/en/products/detail/c-k/OS102011MS2QN1/411602 | CKN9565-ND | Slide switch | 10 | $0.49 | $4.93 | S1-S2
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
