Georgia-Tech-Off-Road/GTOR-DAQ/09 Inventory/inventoryreadme.txt

To be added to the collaborative GTOR inventory Excel sheet,
email Joseph jmeeks33@gatech.edu with your name and let me know to add you.
