Georgia-Tech-Off-Road/GTOR-DAQ/04 Sensors/Strain Gauge/Ziptie_2.15.STL

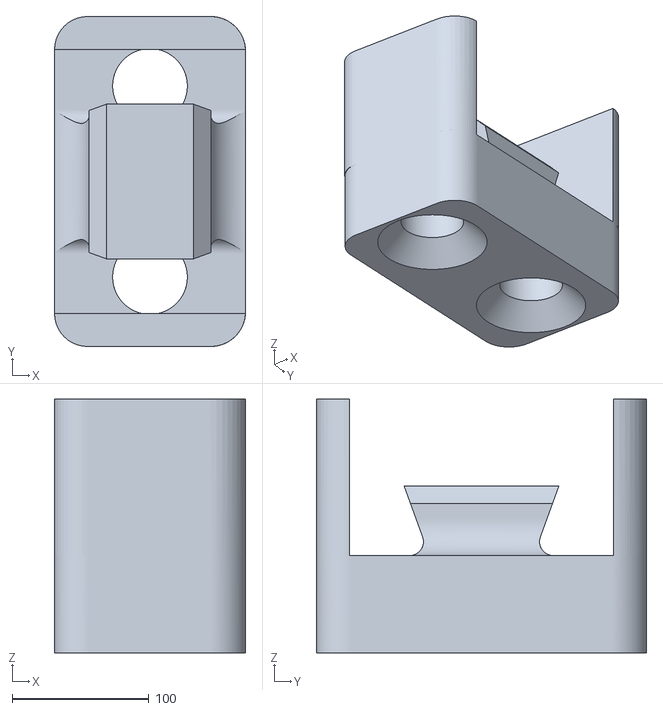
[picture p13: CAD file, 2024-10-29]
04 Sensors/Strain Gauge/Ziptie_2.15.STL
139.7 x 241.3 x 185.4
