Georgia-Tech-Off-Road/GTOR-DAQ/03 DAQ for DumMiEs/Load Cell Instructions.pdf

## DAQ Load Cell Sensor Instructions

1 | Make sure SD card is inserted; DAQ will remove and replace when necessary
2 | Flip switch to “on”
3 | Wait for LED to turn on; this indicates recording has started
4 | Begin testing and recording data
5 | When completed, flip switch to “off”; LED should turn off

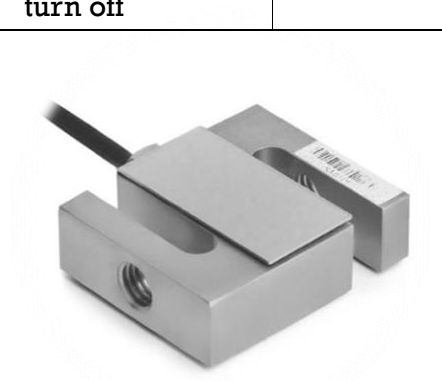
[picture p20: figure]
