Georgia-Tech-Off-Road/GTOR-DAQ/Guides/Hotfix.md

# Hotfix Form

## Overview

**Project Name (Remember Git branch naming rules (NO SPACES)):**
**Affected Software (list in folder format from Github):**

## Objectives
What about this software are you trying to change?

## Timeline
If the hotfix will take longer than one shop-night to implement go ahead and create a timeline like you would for a project proposal.

## Outline of Implementation
Write a super short (like two sentences) explanation of how you will make this change.

## Affected Features
Make a short list of affected features. This is to assist in future debugging if you make a mistake.
