Georgia-Tech-Off-Road/GTOR-DAQ/04 Sensors/Load Cell (Sled Pull)/(Doc. Basis, OLD) GTOR_Load_cell_manual.pdf

# GTOR Load Cell Manual

Peter Chu - pchu34@gatech.edu

February 2021

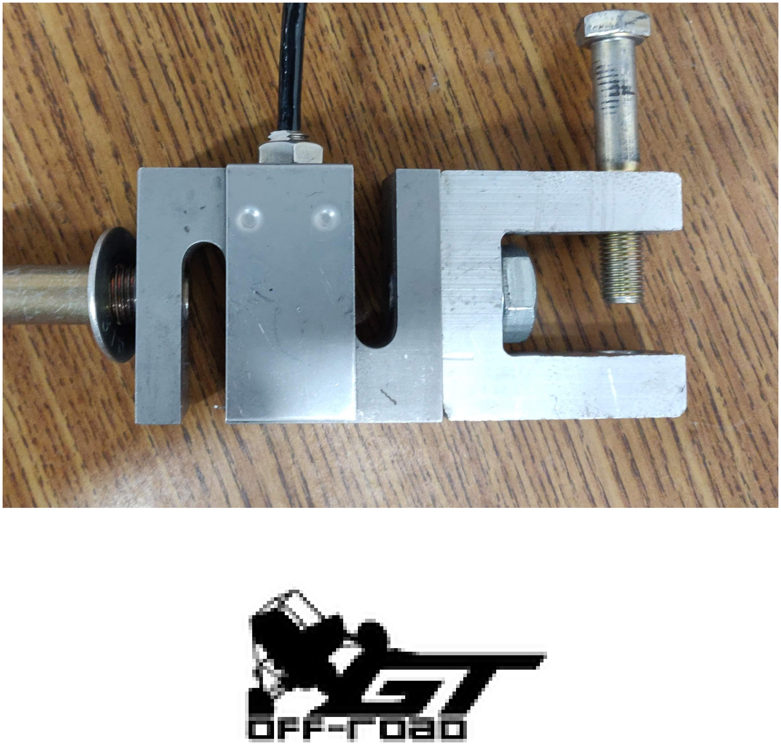
[picture p37: figure]

1

## Contents

1 Parts Identification | 3
2 Electrical Hardware Setup | 4
3 Software Setup | 5

2

## 1 Parts Identification

- Load Cell

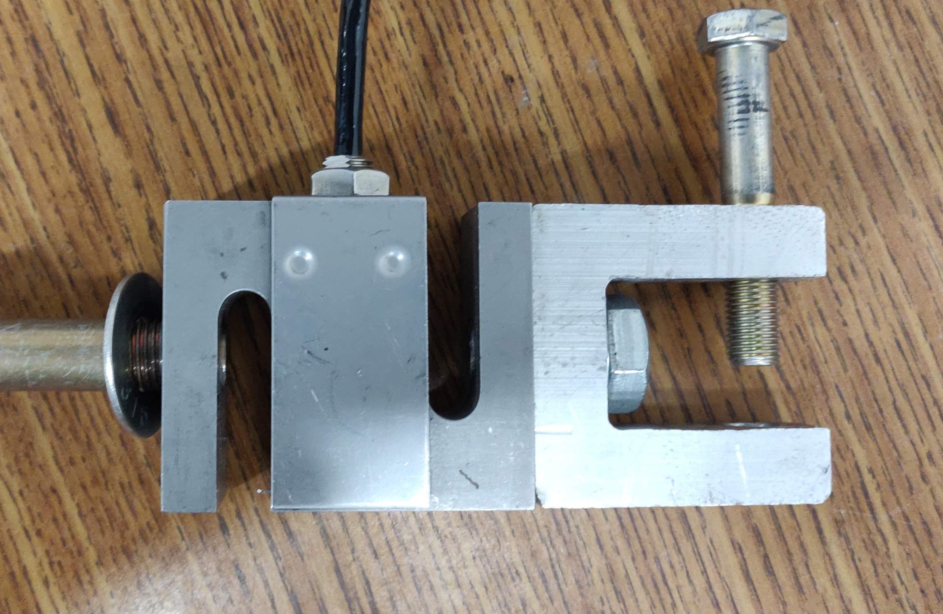
[picture p38: figure]

- Load Cell Amplifier

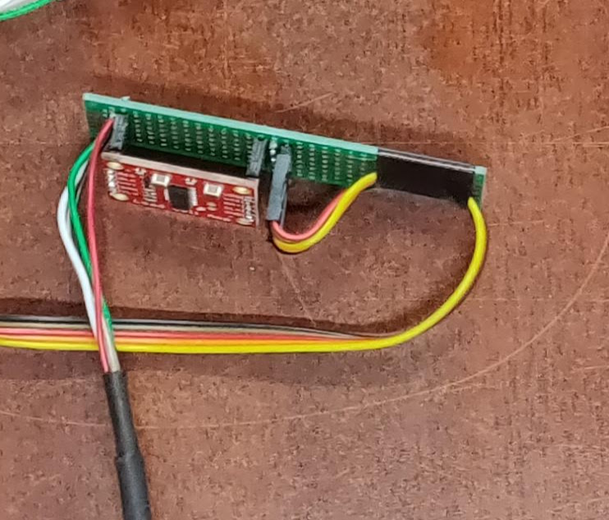
[picture p39: figure]

- Teensy

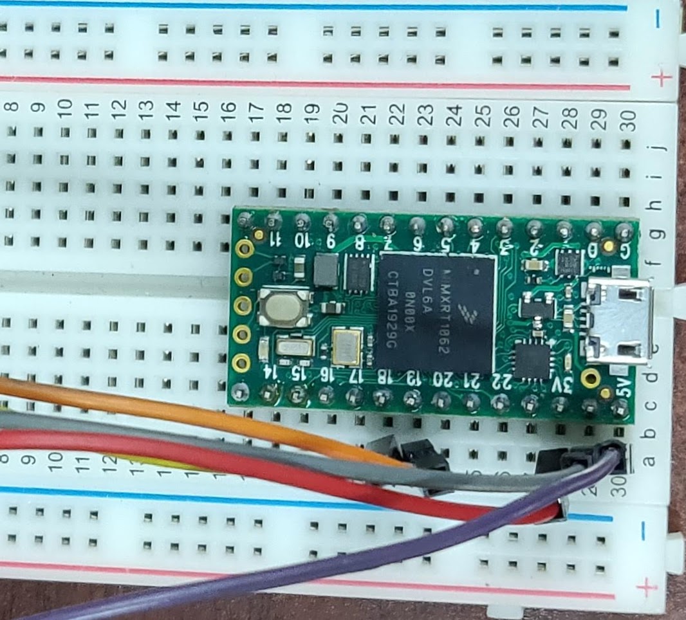
[picture p40: figure]

3

## 2 Electrical Hardware Setup

1. Using the figure below, identify the 4 pin connectors and plug them in. This connects the load cell to the load cell amplifier and Teensy.

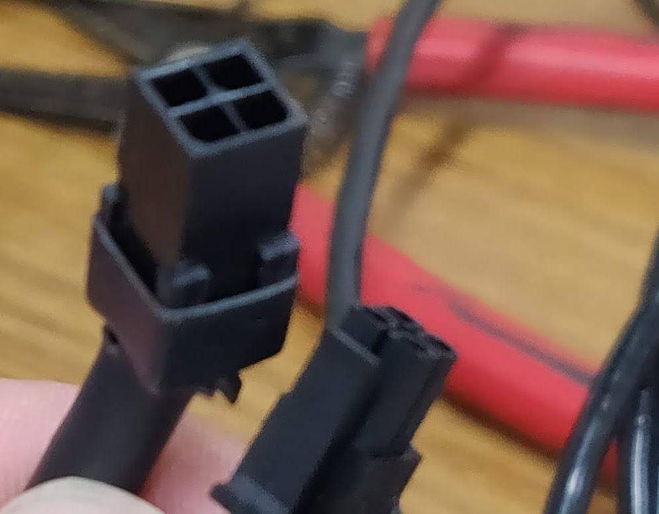
[picture p41: figure]

2. Using the figure below, identify the USB cable and the Teensy. Plug the USB cable into the Teensy and move on to Software setup.

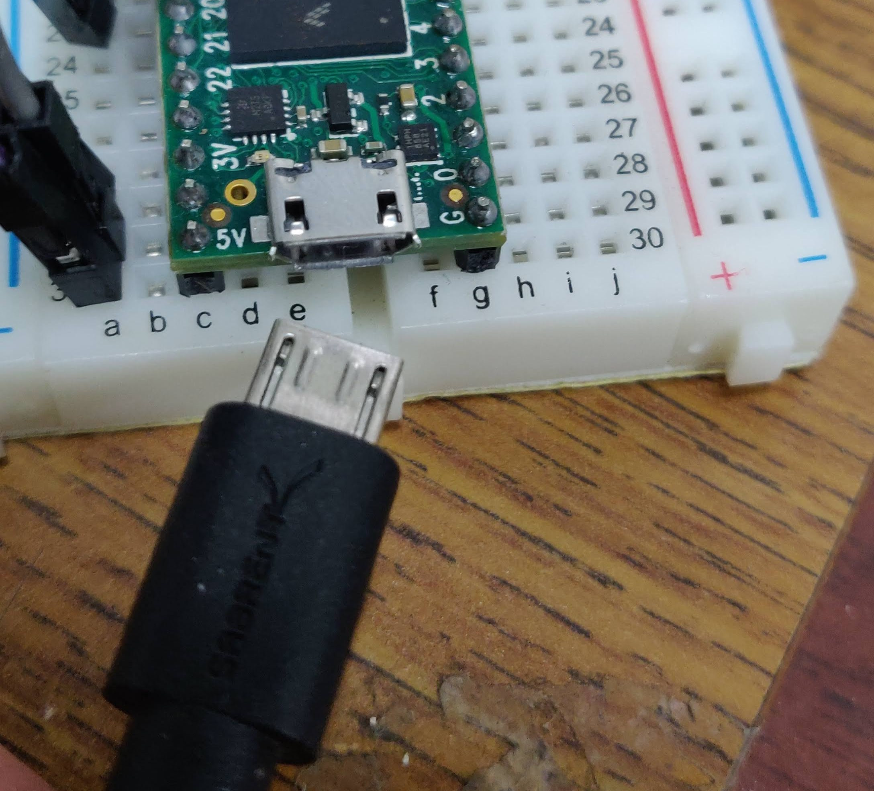
[picture p42: figure]

4

## 3 Software Setup

1. Please go to the Arduino download page (https://www.arduino.cc/en/software) to download the Arduino software on your computer.
2. Please go to the Teensyduino download page (https://www.pjrc.com/teensy/td_download.html) to download the Teensy addon software on your computer for Arduino.
3. Finish the hardware setup before moving on in the software setup
4. Plug the USB cable into your computer
5. Open Arduino and on the menu bar select T ools− > P ort and select the Teensy 4.0 in the serial port section.
6. Also on the menu bar select T ools− > Serial Monitor. Here is where the force data will be printed out. If a window opened, then the data should stream in. If you get a ”Board is not available” error reach out to Peter Chu in Slack or email Peter with the email provided on the title page.

5
