Georgia-Tech-Off-Road/GTOR-DAQ/08 Wireless Measurement Delivery/ConversionLibraries/Note.txt

Note, this copy of conversion libraries will not exist in the final product since that will be built into the overarching data tool. This means some imports and whatnot will need to changed/updated.
