Georgia-Tech-Off-Road/GTOR-DAQ/02 Competitions/DAQ Pack Instructions.pdf

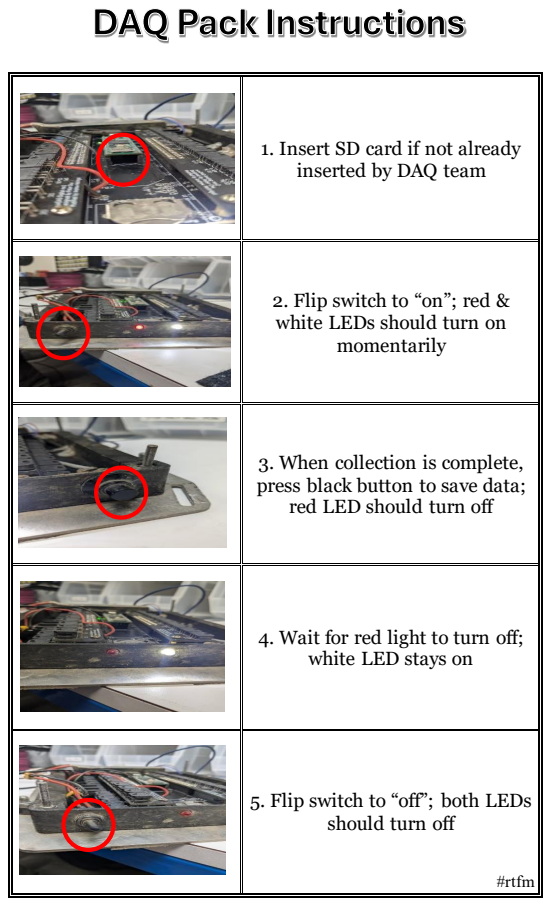
[picture p43: page 1]

1. Insert SD card if not already
inserted by DAQ team

2. Flip switch to “on”; red & white LEDs should turn on momentarily

3. When collection is complete, press black button to save data; red LED should turn off

4. Wait for red light to turn off; white LED stays on

5. Flip switch to “off”; both LEDs should turn off #rtfm
