Georgia-Tech-Off-Road/GTOR-DAQ/(list of files, drawings)

Other design files:
11 CAD/DAQBOXRev12025/DAQBOXRev12025.PrjPcb
11 CAD/DAQBOXRev12025/DebugOutputs.SchDoc
11 CAD/DAQBOXRev12025/MainSchematic.SchDoc
11 CAD/DAQBOXRev12025/PCB2.PcbDoc
11 CAD/DAQBOXRev12025/Sheet1.SchDoc
11 CAD/DAQBOXRev22026/DAQBOXRev2.2026.PrjPcb
11 CAD/DAQBOXRev22026/DebugOutputs.2.SchDoc
11 CAD/DAQBOXRev22026/Filters.2.SchDoc
11 CAD/DAQBOXRev22026/MainSchematic.2.SchDoc
11 CAD/DAQBOXRev22026/PCB2.FINAL.PcbDoc
11 CAD/DAQBOXRev22026/PCB2.TEST.PcbDoc
11 CAD/DAQBOXRev32026/DAQBOXRev3.2026.PrjPcb
11 CAD/DAQBOXRev32026/DebugOutputs.3.SchDoc
11 CAD/DAQBOXRev32026/Filters.3.SchDoc
11 CAD/DAQBOXRev32026/MainSchematic.3.SchDoc
11 CAD/DAQBOXRev32026/PCB_Rev2_Reference.PcbDoc
11 CAD/DAQBOXRev32026/PCB_Rev3_FINAL4LAYER.PcbDoc
11 CAD/Hive Mind 1/Aux Daq Board - Simplified.PrjPcb
11 CAD/Hive Mind 1/AUX DAQ.SchDoc
11 CAD/Hive Mind 1/Inputs.SchDoc
