Georgia-Tech-Off-Road/GTOR-DAQ/05 DAQ Pack/DaqPackCode/DaqPackCode.ino

#include "DaqPack.h"

//create an interval timer (provides more accurate timing than microseconds)
IntervalTimer intervalMicros;

// Initialize analog value flags
volatile bool analogValueFlag1 = false;
volatile bool analogValueFlag2 = false;

// Current analog sensor number being polled
int currentAnalogSensor1 = 0;
int currentAnalogSensor2 = 0;

//general rpm definitions for now
#define MIN_EXPECTED_VALUE 0
#define MAX_EXPECTED_VALUE 2000

//initialize RPM sensors
RPMSensor<RPM_BUFFER_CAPACITY> engineRPM(RPM1, ENGTEETH, MAX_RPM_INTERVAL_MICROS);
RPMSensor<RPM_BUFFER_CAPACITY> frontLeftRPM(RPM2, FLTEETH, MAX_RPM_INTERVAL_MICROS);
RPMSensor<RPM_BUFFER_CAPACITY> frontRightRPM(RPM3, FRTEETH, MAX_RPM_INTERVAL_MICROS);
RPMSensor<RPM_BUFFER_CAPACITY> rearRPM(RPM4, RDTEETH, MAX_RPM_INTERVAL_MICROS);

//dont need to calibrate the brake pressures at start up I don't think
Linear_Analog_Sensor rearBrakePressure(ADC_RESOLUTION, ADC_REFERENCE_VOLTAGE, 2000, 0, 4.5, 0.5, 0, 2000);
Linear_Analog_Sensor frontBrakePressure(ADC_RESOLUTION, ADC_REFERENCE_VOLTAGE, 2000, 0, 4.5, 0.5, 0, 2000);

//create pointers so we can reference these globaly
//Linear_Analog_Sensor * LDSFrontLeft;
//Linear_Analog_Sensor * LDSFrontRight;

//create LDSs
Linear_Analog_Sensor LDSFrontRight(ADC_RESOLUTION, ADC_REFERENCE_VOLTAGE, 7.87402, 0, 5.0, 0.0, 0.0, 10);
Linear_Analog_Sensor LDSFrontLeft(ADC_RESOLUTION, ADC_REFERENCE_VOLTAGE, 7.87402, 0, 5.0, 0.0, 0.0, 10);
Linear_Analog_Sensor LDSRearLeft(ADC_RESOLUTION, ADC_REFERENCE_VOLTAGE, 7.87402, 0, 5.0, 0.0, 0.0, 10);
Linear_Analog_Sensor LDSRearRight(ADC_RESOLUTION, ADC_REFERENCE_VOLTAGE, 7.87402, 0, 5.0, 0.0, 0.0, 10);

//create temp sensors
Linear_Analog_Sensor CVTTemp(ADC_RESOLUTION, ADC_REFERENCE_VOLTAGE, 200, 0, 5.0, 0.0, 0.0, 200);
Linear_Analog_Sensor RearTransferCaseTemp(ADC_RESOLUTION, ADC_REFERENCE_VOLTAGE, 200, 0, 5.0, 0.0, 0.0, 200);

static_assert(sizeof(DataPacket) == 10, "DataPacket size mismatch - check packing");

void setup() {
  //crank up i2c clocks
  Wire.setClock(400000);
  Wire1.setClock(1000000);



  //initialize pins for LEDs, buttons, etc.
  initPins();
  //initialize micros interval timer (updates every 5 microseconds, means our effective maximum polling rate would be 500kHz)
  intervalMicros.begin(&intervalTimerFunction, 5);
  //set the interupt priority to be higher than the default priority of 128 for the attachInterrupts ones (we don't want our time drifting)
  intervalMicros.priority(112);
  //init temp monitor
  tempmon_init();
  //start tempmon
  tempmon_Start();
  //set up time 
  setupTeensyTime();
  //initiliaze serial monitor
  serialMonitor.begin(BAUD);
  //perform outFile init
  if (setUpSD() == -1) {
    status.error_status = status.SD_ERROR;
  };

  if (initDisplay() != 0) {
    Serial.println("Failure setting up the display!");
  }

  Serial.println("NEW CODE");

  updateStatusLEDs();
  updateStatusDisplay();


  pinMode(RPM3, INPUT_PULLDOWN);
  attachInterrupt(digitalPinToInterrupt(RPM3), frontRightRPMInterrupt, RISING);
  pinMode(RPM1, INPUT_PULLDOWN);
  attachInterrupt(digitalPinToInterrupt(RPM1), engineRPMInterrupt, FALLING);
  pinMode(RPM2, INPUT_PULLDOWN);
  attachInterrupt(digitalPinToInterrupt(RPM2), frontLeftRPMInterrupt, RISING);
  pinMode(RPM4, INPUT_PULLDOWN);
  attachInterrupt(digitalPinToInterrupt(RPM4), rearRPMInterrupt, RISING);

  if (initADS1256(ADS_PGA, ADS_DRATE) != 0) {
    status.error_status = status.ADS_ERROR;
  }
  Serial.println("ADS1256 setup successful!");
  
  isRecording = true;
  //init auto save time
  autoSaveTimeMillis = millis();

  status.recording_status = status.READY_TO_RECORD;
  updateStatusLEDs();
  updateStatusDisplay();
  dataAquisitionAndSavingLoop();
}

//do nothing here
void loop() {}

//writes data to SD card
void dataAquisitionAndSavingLoop() {
  errorCheck();
  blockForButtonHold(RECORD_SAVE_BUTTON, BUTTON_HOLD_DURATION); // Must hold the recording button for one second
  status.recording_status = status.RECORDING;
  updateStatusDisplay();
  while(1) {
    digitalWrite(POWER_LED, HIGH);
    //updateDebugLeds();
    //update auto save time
    //check to see if save should be started/stopped
    static uint32_t holdStartMicros = 0;
    static bool tracking = false;
    bool shouldSave = false;

    handleCommands();

    // Serial.println("Gateway1");
    if(SDCardChecker.shouldLog(microsecondsElapsed)) {
      SDCardChecker.updateLastLogTime(microsecondsElapsed);
      if (!isSDCardAccessible()) {
        emitSDError();
      }
    }

    // Serial.println("Gateway2");
    if (digitalRead(RECORD_SAVE_BUTTON) == LOW) {
      if(!tracking) {
        holdStartMicros = safeMicrosecondsElapsed();
        tracking = true;
      } else if (safeMicrosecondsElapsed() - holdStartMicros >= BUTTON_HOLD_DURATION) {
        shouldSave = true;
      }
    } else {
      tracking = false;
    }

    if (Serial.read() == 's') {
      shouldSave = true;
    }

    if (displayLogger.shouldLog(microsecondsElapsed)) {
      unsigned long long startMicros = microsecondsElapsed;
      displayLogger.updateLastLogTime(microsecondsElapsed);
      // updateStatusDisplay() // Takes ~25 ms to fully update, too much time just for an animation
    }

    // Serial.println("Gateway3");
    if (shouldSave) {
      digitalWrite(ERROR_LED, LOW);
      saveTimer.updateLastLogTime(microsecondsElapsed);

      changeRecordingState();

      status.recording_status = status.READY_TO_RECORD;
      updateStatusLEDs();
      updateStatusDisplay();

      blockForButtonHold(RECORD_SAVE_BUTTON, BUTTON_HOLD_DURATION); // Must hold the recording button for one second
      updateStatusDisplay();
      changeRecordingState();

      tracking = false;
    }
    //perform flush check before data check
    if (millis() > autoSaveTimeMillis + 30000) {
      outputFile.flush();
      autoSaveTimeMillis = millis();
    }
    // Serial.println("Gateway4");

    //size of is apparently computed at compile time
    if (isRecording) {
      status.recording_status = status.RECORDING;
      // Only write packet if sufficient time has passed
      DAQData.setData<cmbtl::SensorIndex::MICRO_SEC>(microsecondsElapsed);
      DAQData.setData<cmbtl::SensorIndex::SEC>(microsecondsElapsed / 1000000);
      
      if (debugLogger.shouldLog(microsecondsElapsed)) {
        // Serial.println(DAQData.serializeDataToJSON().c_str());
        debugLogger.updateLastLogTime(microsecondsElapsed);
      }

      // Serial.println("Gateway5");
      recordNextADSValue();
      // Serial.println("Gateway6");
      if(teensyTempLogger.shouldLog(microsecondsElapsed)) {
        float temp = tempmonGetTemp();
        DAQData.setData<cmbtl::SensorIndex::TEENSY_TEMP>(temp);
        writePacket(SensorID::TEENSY_TEMP, temp);
        teensyTempLogger.updateLastLogTime(microsecondsElapsed);
      }
      // Check for RPM updates
      if (engineRPMLogger.shouldLog(microsecondsElapsed)) {
        float RPM = engineRPM.calculateRPM();
        DAQData.setData<cmbtl::SensorIndex::RPM1>((uint32_t) RPM);
        writePacket(SensorID::ENGINE_RPM, RPM);
      }
      if (frontLeftRPMLogger.shouldLog(microsecondsElapsed)) {
        float RPM = frontLeftRPM.calculateRPM();
        DAQData.setData<cmbtl::SensorIndex::RPM2>((uint32_t) RPM);
        writePacket(SensorID::FRONT_LEFT_RPM, RPM);
      }
      if (frontRightRPMLogger.shouldLog(microsecondsElapsed)) {
        float RPM = frontRightRPM.calculateRPM();
        DAQData.setData<cmbtl::SensorIndex::RPM3>((uint32_t) RPM);
        writePacket(SensorID::FRONT_RIGHT_RPM, RPM);
      }
      if (rearRPMLogger.shouldLog(microsecondsElapsed)) {
        float RPM = rearRPM.calculateRPM();
        DAQData.setData<cmbtl::SensorIndex::RPM4>((uint32_t) RPM);
        //writePacket(SensorID::REAR_RPM, RPM);
        writePacket(SensorID::REAR_RPM, digitalRead(RPM3) * 1000.0f);
      }
      // Serial.println("Gateway8");
      //Serial.printf("%s", DAQData.serializeDataToJSON().c_str());
      updateStatusLEDs();
    }
  }
}

inline void recordNextADSValue() {
  static uint8_t index = 0;
  constexpr int PORT_LIST_LENGTH = 4; 

  // List of ADS ports to read from, should wrap around to begining
  constexpr SensorID ads1256SensorList[PORT_LIST_LENGTH] = {LDS_FRONT_LEFT, LDS_FRONT_RIGHT, LDS_REAR_LEFT, LDS_REAR_RIGHT};

  SensorID nextSensor = ads1256SensorList[index];
  uint8_t nextADSPort = getADSPort(nextSensor);
  long result;
  if(!ads1256.safeReadSinglePort(nextADSPort, result)) {
    Serial.printf("%d: timeout reading port %d\n", microsecondsElapsed, nextADSPort);
  }
  if (nextSensor == LDS_FRONT_LEFT) {
    float value = ads1256.convertToVoltage(result);
    writePacket(SensorID::LDS_FRONT_LEFT, value);
    DAQData.setData<cmbtl::SensorIndex::LDSFrontLeft>(value);
  } else if (nextSensor == LDS_FRONT_RIGHT) {
    float value = ads1256.convertToVoltage(result);
    writePacket(SensorID::LDS_FRONT_RIGHT, value);
    DAQData.setData<cmbtl::SensorIndex::LDSFrontRight>(value);
  } else if (nextSensor == LDS_REAR_LEFT) {
    float value = ads1256.convertToVoltage(result);
    writePacket(SensorID::LDS_REAR_LEFT, value);
    DAQData.setData<cmbtl::SensorIndex::LDSRearLeft>(value);
  } else if (nextSensor == LDS_REAR_RIGHT) {
    float value = ads1256.convertToVoltage(result);
    writePacket(SensorID::LDS_REAR_RIGHT, value);
    DAQData.setData<cmbtl::SensorIndex::LDSRearRight>(value);
  } else {
    Serial.printf("recordNextADSValue(): Cannot read from unknown sensor with ID %d", nextSensor);
    status.error_status = status.ERROR;
  }

  index = (index + 1) % PORT_LIST_LENGTH; // Loop back to start
}
//changes recording state and saves file
void changeRecordingState() {
  if(isRecording == true) {
    //outputFile.printf("]");
    if(!isSDCardAccessible()) {
      emitSDError();
    }

    if (outputFile) {
      outputFile.flush();
      outputFile.close();
    }

    Serial.printf("File closed\n");

    display.clearDisplay();
    display.setTextSize(1);
    display.setTextColor(SSD1306_WHITE);
    display.setCursor(0, 0);
    display.printf("%s closed\n", outputFileName.c_str());
    display.display();

    delay(1000); // Delay 4 seconds
    isRecording = false;
    //signal to user that the file saved with a flashbang
    status.recording_status = status.READY_TO_RECORD;

    updateStatusDisplay();
  }
  else {
    String time = String(year()) + "-" + String(month()) + "-" + String(day()) + " " + String(hour()) + "_" + String(minute()) + "_" + String(second());
    SD.mkdir(time.c_str());
    Serial.println(time.c_str());
    // File structConfigFile = SD.open(String("/"+time+"/"+time+"Config.txt").c_str(), FILE_WRITE);
    // structConfigFile.close();

    outputFileName = String("/"+time+".bin");
    outputFile = SD.open(outputFileName.c_str(),  FILE_WRITE);

    if(!outputFile) {
      emitSDError();
    }

    display.clearDisplay();
    display.setTextSize(1);
    display.setTextColor(SSD1306_WHITE);
    display.setCursor(0, 0);
    display.printf("Opening: %s.bin\n", time.c_str());
    display.display();
    delay(1000);

    // Reset flags
    engineRPM.RPMUpdateFlag = false;
    frontLeftRPM.RPMUpdateFlag = false;
    frontRightRPM.RPMUpdateFlag = false;
    rearRPM.RPMUpdateFlag = false;
    teensyTempLogger.updateLastLogTime(microsecondsElapsed);
        
    isRecording = true;
    status.recording_status = status.RECORDING;

    updateStatusDisplay();
  }
}

void updateAnalogValueFlag1() {
  analogValueFlag1 = true;
}

void updateAnalogValueFlag2() {
  analogValueFlag2 = true;
}

inline void initPins() {
  pinMode(POWER_LED, OUTPUT);
  digitalWrite(POWER_LED, HIGH); // Leave at HIGH for basically forever

  pinMode(RECORDING_LED, OUTPUT);
  digitalWrite(RECORDING_LED, LOW);

  pinMode(ERROR_LED, OUTPUT);
  digitalWrite(ERROR_LED, LOW);

  pinMode(RECORD_SAVE_BUTTON, INPUT_PULLUP);
}

void engineRPMInterrupt() {
  static float counter = 0.0f;
  writePacket(SensorID::ENGINE_RPM_TIMESTAMP, counter);
  counter += 1.0f;
  engineRPM.handleInterrupt();
}

void frontLeftRPMInterrupt() {
  static float counter = 0.0f;
  writePacket(SensorID::FRONT_LEFT_RPM_TIMESTAMP, counter);
  counter += 1.0f;
}

void frontRightRPMInterrupt() {
  static float counter = 0.0f;
  writePacket(SensorID::FRONT_RIGHT_RPM_TIMESTAMP, counter);
  counter += 1.0f;
  frontRightRPM.handleInterrupt();
}

void rearRPMInterrupt() {
  static float counter = 0.0f;
  writePacket(SensorID::REAR_RPM_TIMESTAMP, counter);
  counter += 1.0f;
  rearRPM.handleInterrupt();
}

int initADS1256(uint8_t pga, uint8_t drate) {
  Serial.println("Setting up ADS1256...");

  ads1256.InitializeADC();
  ads1256.setAutoCal(ACAL_DISABLED);  // Prevent implicit recalibration

  for (int i = 0; i < 10; i++) { // Attempt 10 times
    ads1256.setPGA(pga);
    if (ads1256.getPGA() == pga) break;
  }

  for (int i = 0; i < 10; i++) { // Attempt 10 times
    ads1256.setDRATE(drate);
    if (ads1256.readRegister(DRATE_REG) == drate) break;
  }

  ads1256.sendDirectCommand(SELFCAL);  // Single clean calibration with final settings
  delay(400);                          // Give it time to complete

  // Read back the above 3 values to check if the writing was succesful
  Serial.print("PGA: ");
  Serial.println(ads1256.getPGA());
  delay(100);
  //--
  Serial.print("DRATE: ");
  Serial.println(ads1256.readRegister(DRATE_REG));
  delay(100);

  // Print full scale calibration (FSC) and offset calibration (OFC) for debugging
  // See p.g 24 of ADS1256 datasheet for formula and ideal values
  Serial.printf("FSC: %x", (uint8_t) ads1256.readRegister(FSC2_REG));
  delay(100);
  Serial.printf("%x", (uint8_t) ads1256.readRegister(FSC1_REG));
  delay(100);
  Serial.printf("%x\n", (uint8_t) ads1256.readRegister(FSC0_REG));
  delay(100);

  Serial.printf("OFC: %x", (uint8_t) ads1256.readRegister(OFC2_REG));
  delay(100);
  Serial.printf("%x", (uint8_t) ads1256.readRegister(OFC1_REG));
  delay(100);
  Serial.printf("%x\n", (uint8_t) ads1256.readRegister(OFC0_REG));

  // --- Error Handling ---
  uint8_t pgaResult = ads1256.getPGA();
  uint8_t drateResult = ads1256.readRegister(DRATE_REG);

  bool error = false;
  if (pga != pgaResult) {
    Serial.println("Unable to correctly set PGA value");
    error = true;
  }
  if (drate != drateResult) {
    Serial.println("Unable to correctly set drate value");
    error = true;
  }

  // Failure
  if (error)
    return -1;

  // Success
  return 0;
}



int initDisplay() {
  if (!display.begin(SSD1306_SWITCHCAPVCC, OLED_ADDR)) {
    Serial.println("SSD1306 failed");
    return -1;
  }
  display.clearDisplay();
  display.setTextSize(1);
  display.setTextColor(SSD1306_WHITE);
  display.setCursor(0, 0);
  display.println("Hello DAQ!");
  display.display();  // must call this to push buffer to screen
  return 0;
}

constexpr uint8_t getADSPort(SensorID sensorID) {
  switch (sensorID) {
    case LDS_FRONT_LEFT:
      return SING_4;
    case LDS_FRONT_RIGHT:
      return SING_6;
    case LDS_REAR_LEFT:
      return SING_5;
    case LDS_REAR_RIGHT:
      return SING_7;
    default:
      return -1;
  }
}

void blockForButtonHold(int buttonPin, uint32_t holdMicroseconds) {
  uint32_t heldMicroseconds = 0;
  uint32_t lastHeldTime = 0;
  uint32_t debounceMicros = 1000;
  bool firstHold = true;
  while(true) {
    if (heldMicroseconds >= holdMicroseconds) {
      onButtonHeldConfirmed();
      return;
    }
    if (digitalRead(buttonPin) == LOW) {
      uint32_t currMicros = safeMicrosecondsElapsed();
      if (!firstHold) {
        heldMicroseconds += currMicros - lastHeldTime;
        // Serial.println("Button held.");
      }
      firstHold = false;
      lastHeldTime = currMicros;
    } else if ((safeMicrosecondsElapsed() - lastHeldTime) < debounceMicros) { // Prevent noisy values from breaking our hold
      continue;
    }
    else {
      firstHold = true;
      heldMicroseconds = 0;
    }
  }
}

void rapidFlash(int ledPin, uint32_t durationMilliseconds) {
  uint32_t flashRate = 50;
  uint32_t startTime = millis();
  uint32_t flashCounter = 0;

  while (millis() - startTime <= durationMilliseconds) {
    delay(flashRate);
    digitalWrite(ledPin, flashCounter % 2 ? HIGH : LOW);
    flashCounter++;
  }
}

void errorFlash(int ledPin) {
  while (true) {
    digitalWrite(ledPin, LOW);
  }
}

void writePacket(SensorID id, float value) {
  if (!isRecording) return;
  DataPacket packet;
  packet.sync = 0xAA;
  packet.sensorID = id;
  // Get in units of sec 10^-4
  uint32_t ts = safeTimestamp();
  packet.timestamp100Micros = ts;
  packet.value = value;

  outputFile.write(&packet, sizeof(packet));
}

uint32_t safeTimestamp() {
  noInterrupts();
  uint64_t ts = (uint64_t) microsecondsElapsed;
  interrupts();
  return (uint32_t) (ts / 100);
}

inline uint32_t safeMicrosecondsElapsed() {
  uint32_t ts;
  noInterrupts();
  ts = (uint32_t) microsecondsElapsed;
  interrupts();
  return ts;
}

void updateStatusLEDs() {
  digitalWrite(POWER_LED, HIGH);
  if (status.recording_status == status.RECORDING) {
    digitalWrite(RECORDING_LED, HIGH);
  } else {
    digitalWrite(RECORDING_LED, LOW);
  }
}

void updateStatusDisplay() {
  display.clearDisplay();
  display.setTextSize(1);
  display.setTextColor(SSD1306_WHITE);
  display.setCursor(0, 0);

  static uint counter = 0;


  if (status.recording_status == status.NOT_READY_TO_RECORD) {
    display.println("Recording Status: Not Ready");
  }
  else if (status.recording_status == status.READY_TO_RECORD) {
    display.println("Recording Status: Ready to record");
  }
  else if (status.recording_status == status.RECORDING) {
      display.println("Recording Status: Recording");
  }

  if (status.error_status == status.ERROR) {
    display.setTextColor(SSD1306_WHITE);
    display.println("Error Status: ERROR");
  }
  else if (status.error_status == status.SD_ERROR) {
    display.println("Error Status: SD Card Error!");
    display.println("Please reinsert the SD card and restart");
  }
  else if (status.error_status == status.ADS_ERROR) {
    display.println("Error Status: ADS failed to initialize, restart");
  }
  else if (status.error_status == status.NO_ERROR) {
    display.setTextColor(SSD1306_WHITE);
    display.println("Error Status: None");
  }

  if (status.recording_status == status.READY_TO_RECORD && status.error_status == status.NO_ERROR) {
    display.printf("To begin recording, please hold the button for atleast %d secs.\n", BUTTON_HOLD_DURATION / 1000000);
  }

  if (status.recording_status == status.RECORDING && status.error_status == status.NO_ERROR) {
    display.printf("Output File: %s\n", outputFileName.c_str());
    display.println("Hold to close file");
  }

  display.display();
  counter++;
}

bool isSDCardAccessible() {
  File testFile = SD.open("/_healthcheck.tmp", FILE_WRITE);
  if (!testFile) {
    return false;
  }
  testFile.close();
  SD.remove("/_healthcheck.tmp");
  return true;
}

inline void errorCheck() {
  if (status.error_status != status.NO_ERROR) {
    updateStatusDisplay();
    errorFlash(ERROR_LED);
  }
}

inline void emitSDError() {
  status.error_status = status.SD_ERROR;
  updateStatusDisplay();
  errorFlash(ERROR_LED);
}

inline void emitADSError() {
  status.error_status = status.ADS_ERROR;
  updateStatusDisplay();
  errorFlash(ERROR_LED);
}

inline void onButtonHeldConfirmed() {
  digitalWrite(RECORDING_LED, HIGH);
  while (digitalRead(RECORD_SAVE_BUTTON) == LOW) {} // Wait for release so we don't retrigger
  digitalWrite(RECORDING_LED, LOW);
  delay(250);
}

inline void handleCommands() {
  if (Serial.available() > 0) {
    String command = Serial.readStringUntil('\n');
    command.trim(); 

    if (command == "LIST") {
      File root = SD.open("/");
      listFiles(root);
    } 
    else if (command.startsWith("GET ")) {
      String filename = command.substring(4);
      sendFile(filename);
    }
  }
}

void listFiles(File dir) {
  while (true) {
    File entry = dir.openNextFile();
    if (!entry) break; 
    
    if (!entry.isDirectory()) {
      Serial.print("FILE:");
      Serial.print(entry.name());
      Serial.print("|SIZE:");
      Serial.println(entry.size());
    }
    entry.close();
  }
  Serial.println("END_LIST");
}

void sendFile(String filename) {
  if (!SD.exists(filename.c_str())) {
    Serial.println("ERROR: File not found.");
    return;
  }

  File dataFile = SD.open(filename.c_str());
  if (dataFile) {
    Serial.println("START_TRANSFER");
    // Stream the file bytes directly
    while (dataFile.available()) {
      Serial.write(dataFile.read());
    }
    dataFile.close();
    Serial.println("\nEND_TRANSFER");
  } else {
    Serial.println("ERROR: Could not open file.");
  }
}
