Georgia-Tech-Off-Road/GTOR-DAQ/07 Applications/Local Data Tool/DAQ.py

import tkinter as tk
from tkinter import filedialog
from tkinter import ttk
import os
import importlib
import threading
import time
import sys
import csv
import json
import subprocess
from gui import launch_daq_gui

#ADD DATA STUFF
import DataDownloader
import ProcessingPrograms
import Updater
import Visualizers

#INSTALLER IMPORTS FINISHED





cuda = False

try:
    from ProcessingPrograms.cudaSetup import check_cuda_available, check_compiled
    #create a global bool for if cuda

    #check if cuda is available
    if check_cuda_available():
        cuda = True
        cudaFileList = ["cudaConvolver.cu", "RPMSpikeFilter.cu"]
        cudaBaseDir = "fancyCudaStuff/"
        moduleBaseName = "ProcessingPrograms.fancyCudaStuff."
        for cudaFile in cudaFileList:
            print(cudaFile)
            moduleName = moduleBaseName + "".join(cudaFile[:-3])
            if not check_compiled(moduleName, cudaBaseDir + cudaFile):
                cuda = False
                print("cuda Failed :(")
except:
    pass



# Creates the main window
root = tk.Tk()
root.title("Main Page")
root.geometry("800x500")

#define function to run when someone xs out to make sure everything closes
def onXOut():
    sys.exit(0)

#link it to root
root.protocol("WM_DELETE_WINDOW", onXOut)
with open("Settings/Settings.csv") as settingsf:
    reader = csv.reader(settingsf)
    settingsData = list(reader)



# Function to go to Data Processing Tool
def dataProcessingTool():
    #hide the main page
    root.withdraw()
    # Create a new window for the data processing tool
    dataProcessingToolPage = tk.Toplevel(root)
    dataProcessingToolPage.title("Data Downloader Tool")
    dataProcessingToolPage.geometry("800x500")
    #define a function to handle window being closed
    def onClose():
        root.deiconify()
        dataProcessingToolPage.destroy()
    #bind the onClose function
    dataProcessingToolPage.protocol("WM_DELETE_WINDOW", onClose)
    #nice little alert message box
    def show_alert(message):
        alert = tk.Toplevel(dataProcessingToolPage)
        alert.title("Alert")
        alert.geometry("350x400")
            
        tk.Label(alert, text=message, wraplength=200).pack(pady=10)
        tk.Button(alert, text="Dismiss", command=alert.destroy).pack(pady=5)
        root.withdraw()
    global useDefaultConfig
    if settingsData[1][3] == "False":
        useDefaultConfig = tk.IntVar(value=0)
    else:
        useDefaultConfig = tk.IntVar(value=1)
    global outputPath
    outputPath = None
    global chosePath
    chosePath = False
    def openHowTo():
        #find the DataProcessingTool.txt file
        howToFilePath = "Guides/DataProcessingTool.txt"
        #open the howToFile file in notepade                    (See if this works on mac.....)
        if sys.platform.startswith("win"):  # Windows
            os.system(f'notepad.exe {howToFilePath}')
        elif sys.platform.startswith("darwin"):  # Mac
            os.system(f'open {howToFilePath}')
    def chooseFile():
        # Open file dialog and get the file path
        global filePath, outputPath
        filePath = filedialog.askopenfilename()
        # Display the file path in the label
        fileSelectLabel.config(text=f"Selected file: {filePath}")

        if outputPath == None:
            outputPath = os.path.dirname(filePath)
            outputSelectLabel.config(text=f"Selected output path: {outputPath}")
        #update the buttons to allow the file to be operated on
        updateButtons()

    def updateButtons():
        #loop through every frame in the data processing page
        for frame in dataProcessingToolPage.winfo_children():
            if isinstance(frame, tk.Frame):
                #loop through every widget in the frame
                for widget in frame.winfo_children():
                    #if the widget is a button and isn't the chooseFile button then hide it
                    if widget["text"] != "Choose File" and widget["text"] != "How To"  and isinstance(widget, tk.Button):
                            widget.grid_forget()
        #if a filePath has been chosen
        if ('filePath' in globals()):
                #if the filepath isn't on the main OS drive only display the download button
                if ".bin" in filePath:
                    outputButton.grid(row=0,column=1,padx=20)
                    binButton.grid(row=0, column=2, padx=20)
                    legacyButton.grid(row=0, column=3, padx=20)
                elif "C:/" not in filePath and sys.platform.startswith("win"):
                    downloadButton.grid(row=0, column=1, padx=20)
                    outputButton.grid(row=0,column=2,padx=20)
                elif ".csv" in filePath:
                    customButton.grid(row=1,column=1,padx=20)
                    configCheckbox.grid(row=2, column=3, padx=20)
                #otherwise display everything but the download button
                else: 
                    indexButton.grid(row=1,column=0,padx=20)
                    customButton.grid(row=1,column=1,padx=20)
                    splitButton.grid(row=1, column=2, padx=20)
                    outputButton.grid(row=2, column=0, padx=20)
                    prButton.grid(row=2, column=2, padx=20)
                    legacyButton.grid(row=2,column=1,padx=20)
                    excelButton.grid(row=3,column=1,padx=20,pady=10)
                    analysisButton.grid(row=4,column=1,padx=20)

    def downloadData():
        #create a new page for the progress bar
        global outputPath, chosePath
        progressBarPage = tk.Toplevel(dataProcessingToolPage)
        progressBarPage.title("Download Progress")
        progressBarPage.geometry("500x700")
        destinationFilePath = str(os.getcwd()+ "\\"+ os.path.basename(filePath))
        #open the file to create it to prevent any problems with later code being unable to find the target
        file = open(os.path.basename(destinationFilePath), "a")
        file.close()
        #if the user does not select a file path, default to current CWD
        if not chosePath:
            destinationFilePath = os.getcwd() + "\\Configs\\" + os.path.basename(filePath)
        else:
            destinationFilePath = outputPath + "\\" + os.path.basename(filePath)
        #use multithreading to allow the download to run seperately from the progress bar updater (more zoom zoom)
        downloadThread = threading.Thread(target = DataDownloader.downloadData, args = (filePath, destinationFilePath, outputPath, chosePath))
        progressBarThread = threading.Thread(target = DataDownloader.updateProgressBar, args = (filePath, destinationFilePath, progressBarPage, dataProcessingToolPage, outputPath, chosePath))
        #start threads
        downloadThread.start()
        progressBarThread.start()
        #hide main data processing page to prevent people from breaking things
        dataProcessingToolPage.withdraw()
        #run update buttons to make sure everything's in the right place once the page comes back (it'll be unhidden by progress bar thread once it sees that the file has finished being downloaded
        updateButtons()
        #if no Configs folder then create one

        #get the file path for the config file included with the data
        configDST = os.getcwd() + "\\Configs\\" + os.path.basename(filePath).split('.')[0] + "Config.txt"
        #create a target file
        file = open(configDST, "w")
        file.close()
        #build out the source filepath
        configSRCLIST = filePath.split("/")
        configSRCLIST[-1] = "Config.txt"
        configSRC = "/".join(configSRCLIST)
        sourceFileSize = os.path.getsize(configSRC)
        #create the thread and download the config file (this isn't tracked since it's such a short download)
        configDownloadThread = threading.Thread(target = DataDownloader.downloadData, args = (configSRC, configDST, outputPath, chosePath))
        configDownloadThread.start()

    def outputDestination():
        global chosePath
        global outputPath
        outputPath = filedialog.askdirectory(title="Select Output Folder")
        #lets the user choose a different file path
        if outputPath:
            chosePath = True
        else:
            chosePath = False
        outputSelectLabel.config(text=f"Selected output path: {outputPath}")

    def custom():                           # custom data visualizer
        customWindow = tk.Toplevel()
        customWindow.title("Visualizer")
        customWindow.geometry("1000x800")

        # Label and Entry for column number
        label = tk.Label(customWindow, text="Enter 1+ indeces separated by commas (i.e. 2,3,4 or just 2)\nNote that index 0 = column #1.\nSensor data starts at 1.")
        label.pack(pady=5)
        columnEntry = tk.Entry(customWindow)
        columnEntry.pack(pady=5)

        # Plotly checkbox
        plotlyCheckVar = tk.IntVar(value=0)
        plotCheckbox = tk.Checkbutton(customWindow, text="Check to use Plotly (slower, more detailed)", variable=plotlyCheckVar)
        plotCheckbox.pack(pady=5)

        # Scale frame and entry
        scaleFrame = tk.Frame(customWindow)
        scaleFrame.pack(pady=25)
        scaleLabel = tk.Label(customWindow, text="Enter # to scale brake pressure data (to view BP data alongside RPM data), or leave blank")
        scaleLabel.pack(pady=0)
        scaleEntry = tk.Entry(customWindow)
        scaleEntry.pack(pady=3)

        visFrame = tk.Frame(customWindow)
        visFrame.pack(pady=10)
        visLabel = tk.Label(customWindow, text="Select button if you want to display smoothed data or if you want smoothed data AND normal data")
        visLabel.pack(pady=0)
        visModeVar = tk.StringVar(value="normal")  # default to normalVis
        normalRadio = tk.Radiobutton(customWindow, text="Normal Data", variable=visModeVar, value="normal")  # raw data only
        smoothRadio = tk.Radiobutton(customWindow, text="Smoothed Data", variable=visModeVar, value="smooth")  # smoothed only
        overlayRadio = tk.Radiobutton(customWindow, text="Overlay Smoothed & Raw", variable=visModeVar, value="overlay")  # both

        normalRadio.pack(pady=2)
        smoothRadio.pack(pady=2)
        overlayRadio.pack(pady=2)
        def runVisualizer():
            scale = scaleEntry.get().strip()
            if scale == "":
                scale = 1
            else:
                scale = float(scale)

            columnNumber = columnEntry.get()
            columnNumber = list(map(int, columnNumber.split(",")))

            # Savitzky-Golay parameters
            smoothingWindow = 41  # odd number
            polyorder = 2

            # Determine visualization mode booleans
            normalVis = visModeVar.get() == "normal"
            smoothVis = visModeVar.get() == "smooth"
            overlayVis = visModeVar.get() == "overlay"

            visualizerThread = threading.Thread(
                target=Visualizers.TestVisualizer.testVisualizer,
                args=(ProcessingPrograms.analysis.dfRAM, filePath, columnNumber, customWindow, int(useDefaultConfig.get()),
                      plotlyCheckVar.get(), scale, smoothingWindow, polyorder,
                      normalVis, smoothVis, overlayVis)
            )
            visualizerThread.start()
        def showIndices():
            indexThread = threading.Thread(target=Visualizers.indexviewer.indices, args = (filePath,customWindow))
            indexThread.start()

        createGraphButton = tk.Button(customWindow, text="Create Graph", font=("Helvetica", 12, "bold"), command=runVisualizer)
        createGraphButton.pack(pady=10)
        indexViewButton = tk.Button(customWindow, text= "Show File Indices", command=showIndices)
        indexViewButton.pack(pady=10)

    def prHelper():
        prPage = tk.Toplevel()
        prPage.title("Polling Rate Helper")
        prPage.geometry("900x600")
        def prCustom():
            customWindow = tk.Toplevel()
            customWindow.title("Visualizer")
            customWindow.geometry("900x600")
            # Label and Entry for column number
            label = tk.Label(customWindow, text="Enter 1 index\nNote that index 0 = column #1.\nSensor data starts at 1.")
            label.pack(pady=5)
            sensorType = tk.Entry(customWindow)
            sensorType.pack(pady=5)
            def polling(): #VISUALIZER
                sensorNumber = sensorType.get()
                sensorNumber = int(sensorNumber)
                pollingThread = threading.Thread(target = ProcessingPrograms.PRHelper.PollingRateList, args = (filePath,prPage,sensorNumber))
                pollingThread.start()
            createGraphButton = tk.Button(customWindow, text="Create Graph",font=("Helvetica", 12, "bold"), command=polling)
            createGraphButton.pack(pady=10)

        def avg():
            avgThread = threading.Thread(target = ProcessingPrograms.PRHelper.FindPollingRate, args = (filePath,prPage))
            avgThread.start()

        pollingButton = tk.Button(prPage, text="Graph polling rate and sensor value vs. time", command=prCustom)
        avgButton = tk.Button(prPage, text="Calculate average polling rate", command=avg)
        #percentButton = tk.Button(prPage, text="Calculate percentile", command=percent)
        pollingButton.grid(pady=50,padx=50)
        avgButton.grid(pady=20,padx=50)
        #percentButton.pack(padx=20)
    def analyze():
        anaPage = tk.Toplevel()
        anaPage.title("Analysis Tool")
        anaPage.geometry("700x600")
        def ram():
            df = ProcessingPrograms.analysis.ram(filePath,anaPage)
            show_alert("File loaded into RAM!")
        def convolute():
            if ProcessingPrograms.analysis.dfRAM is None:
                show_alert("Load into Ram first!")
                return
            anaThread = threading.Thread(target = ProcessingPrograms.analysis.kernel, args = (ProcessingPrograms.analysis.dfRAM, anaPage, cuda))
            anaThread.start()
        def rpmSpikeFilter():
            if analysis.dfRAM is None:
                show_alert("Load into Ram first!")
                return
            spikeThread = threading.Thread(target = ProcessingPrograms.analysis.rpmSpikeFilter, args = (analysis.dfRAM, anaPage, cuda))
            spikeThread.start()
        def save():
            if ProcessingPrograms.analysis.dfRAM is None:
                show_alert("Load into Ram first!")
                return
            saveThread = threading.Thread(target = ProcessingPrograms.analysis.save, args = (ProcessingPrograms.analysis.dfRAM, anaPage))
            saveThread.start()
        ramButton = tk.Button(anaPage, text="Load into RAM",command=ram)
        ramButton.pack(pady=20)
        kernelButton = tk.Button(anaPage, text="Convolution", command=convolute)
        kernelButton.pack(pady=5)
        rpmSpikeFilterButton = tk.Button(anaPage, text="RPM Spike Filter", command = rpmSpikeFilter)
        rpmSpikeFilterButton.pack(pady=5)
        saveButton = tk.Button(anaPage, text="Save to File", command = save)
        saveButton.pack(pady=5)

    def indices(filePath):
        import json
        import tkinter as tk
        from tkinter import ttk
        import os

        with open(filePath, "r") as f:
            data = json.load(f)

        all_keys = []
        seen = set()
        for obj in data:
            for key in obj:
                if key not in seen:
                    seen.add(key)
                    all_keys.append(key)

        variables = {f"Index {idx}": col for idx, col in enumerate(all_keys)}

        # GUI
        indexWindow = tk.Toplevel()
        indexWindow.title(f"Indices for {os.path.basename(filePath)}")
        indexWindow.geometry("700x600")

        canvas = tk.Canvas(indexWindow)
        scrollbar = ttk.Scrollbar(indexWindow, orient="vertical", command=canvas.yview)
        scrollFrame = ttk.Frame(canvas)
        scrollFrame.bind("<Configure>", lambda e: canvas.configure(scrollregion=canvas.bbox("all")))

        canvas.create_window((0, 0), window=scrollFrame, anchor="nw")
        canvas.configure(yscrollcommand=scrollbar.set)
        canvas.pack(side="left", fill="both", expand=True)
        scrollbar.pack(side="right", fill="y")

        for varName, value in variables.items():
            tk.Label(scrollFrame, text=f"{varName}: {value}").pack(anchor="w", padx=10, pady=2)



    def splitFile():            #used for splitting large files into several smaller ones
        fileSplitPage = tk.Toplevel()
        fileSplitPage.title("File Splitter")
        fileSplitPage.geometry("1000x800")
        label = tk.Label(fileSplitPage, text="Enter number of data sets to keep per file or write 'd' for default (10,000,000)")
        label.pack(pady=5)
        splitEntry = tk.Entry(fileSplitPage)
        splitEntry.pack(pady=5)
        def split():
            splitNum = splitEntry.get()
            if str(splitNum) == 'd':
                splitNum = 10000000
            else:
                splitNum = int(splitNum)
            splitThread = threading.Thread(target = ProcessingPrograms.FileSplitter.split, args = (filePath, splitNum, fileSplitPage))
            splitThread.start()
        splitterButton = tk.Button(fileSplitPage, text="Split Files",font=("Helvetica", 12, "bold"), command=split)
        splitterButton.pack(pady=10)
    def excel():
        excelPage = tk.Toplevel()
        excelPage.title("Excel Converter")
        excelPage.geometry('800x400')
        def convertExcel():
            excelThread = threading.Thread(target = ProcessingPrograms.ExcelConverter.convertExcel, args = (filePath, excelPage, outputPath))
            excelThread.start()
        convertButton = tk.Button(excelPage, text="Convert json-formatted .txt file to Excel spreadsheet", command=convertExcel)
        convertButton.pack(pady=10)
        convertLabel = tk.Label(excelPage, text='Tip: For best results, choose an output destination on the previous window')
        convertLabel.pack(pady=5)
    def binConvert():
        #update the buttons to allow the file to be operated on
        global chosePath
        global outputPath
        # binThread = threading.Thread(target = ProcessingPrograms.BinFileTranslator.binConverter, args = (filePath,chosePath,outputPath))
        fileName = os.path.basename(filePath)
        baseName, _ = os.path.splitext(fileName)
        outputFile = os.path.join(outputPath, baseName + ".json")
        print(f"Converting {outputPath}")

        def convertAndNotify():
            ProcessingPrograms.NewBinFileTranslator.translate_and_write(filePath, outputFile)
            # Show a popup when conversion is done
            alert = tk.Toplevel(dataProcessingToolPage)
            alert.title("Done")
            alert.geometry("300x150")
            tk.Label(alert, text=f"Conversion complete!\nSaved to:\n{outputFile}", wraplength=250).pack(pady=20)
            tk.Button(alert, text="OK", command=alert.destroy).pack(pady=5)

        binThread = threading.Thread(target=convertAndNotify)
        #start the thread
        binThread.start()
        
    def legacy():
        legacyPage = tk.Toplevel()
        legacyPage.title("Legacy Functions")
        legacyPage.geometry("800x600")
        def editConfig():
            if useDefaultConfig.get() == 1:
                configFilePath = "Configs/defaultConfig.txt"
            else:
                configFilePathList = filePath.split("/")
                configFilePathList[-1] = "Configs/" + configFilePathList[-1] + "Config.txt"
                configFilePath = "/".join(configFilePathList)
            #open the config file in notepade (See if this works on mac.....)
            if sys.platform.startswith("win"):  # Windows
                os.system(f'notepad.exe {configFilePath}')
            elif sys.platform.startswith("darwin"):  # Mac
                os.system(f'open {configFilePath}')
        def processData():
            global chosePath
            global outputPath
            #create a page for the progress bar
            progressBarPage = tk.Toplevel(dataProcessingToolPage)
            progressBarPage.title("Translation Progress")
            progressBarPage.geometry("800x600")
            #create the thread
            dataProcessingThread = threading.Thread(target = ProcessingPrograms.DataTranslator.translateData, args = (filePath, progressBarPage, dataProcessingToolPage, int(useDefaultConfig.get()),outputPath,chosePath,settingsData))
            #start the thread
            dataProcessingThread.start()
            #hide the main data processor page
            dataProcessingToolPage.withdraw()
        def ogBinConvert():
                #update the buttons to allow the file to be operated on
                global chosePath
                global outputPath
                ogBinThread = threading.Thread(target = ProcessingPrograms.BinFileTranslator.ogBinConverter, args = (filePath,chosePath,outputPath,settingsData))
                #start the thread
                ogBinThread.start()
        configCheckbox = tk.Checkbutton(legacyPage, text="Use default config", variable=useDefaultConfig)
        configEditButton = tk.Button(legacyPage, text="Edit Config", command=lambda: editConfig())
        processButton = tk.Button(legacyPage, text="Process Data", command=lambda: processData())
        ogBinButton = tk.Button(legacyPage, text="Convert .bin to .txt", command=lambda: ogBinConvert())
        configCheckbox.pack(pady=20)
        configEditButton.pack(pady=20)
        processButton.pack(pady=20)
        ogBinButton.pack(pady=20)

    #howToButton
    howToButton = tk.Button(dataProcessingToolPage, text="How To", command=lambda: openHowTo())
    howToButton.pack()
    
    #create a button to select the file to be processed
    fileSelectButton = tk.Button(dataProcessingToolPage, text="Choose File",font=("Helvetica", 14, "bold"), command=chooseFile)
    fileSelectButton.pack(pady=10)
    
    #creates a button to use a usb connection GUI
    usbSelectButton = tk.Button(dataProcessingToolPage, text="Use USB Connection", font=("Helvetica", 14, "bold"),command=launch_daq_gui)
    usbSelectButton.pack(pady=10)
  
    #create a label to show the file selected
    fileSelectLabel = tk.Label(dataProcessingToolPage, text="No file selected")
    fileSelectLabel.pack(pady=5)

    outputSelectLabel = tk.Label(dataProcessingToolPage, text = "No output path selected")
    outputSelectLabel.pack(pady=5)

    #Create a frame for the buttons
    buttonFrame = tk.Frame(dataProcessingToolPage)
    buttonFrame.pack(pady=20)

    #Create and place the buttons in a single row on the second page
    downloadButton = tk.Button(buttonFrame, text="Download Data File", command=lambda: downloadData())
    splitButton = tk.Button(buttonFrame, text = "Split large txt file into smaller files", command = lambda: splitFile())
    customButton = tk.Button(buttonFrame, text="Data Visualizer", font=("Helvetica", 12, "bold"),fg="navy",bg="gold", command=lambda: custom())
    indexButton = tk.Button(buttonFrame, text= "Show File Indeces", command=lambda: indices(filePath))
    outputButton = tk.Button(buttonFrame, text = "Choose output destination...", command=lambda: outputDestination())
    prButton = tk.Button(buttonFrame, text= "Polling Rate Helper", command=lambda: prHelper())
    legacyButton = tk.Button(buttonFrame, text="Legacy Functions", command=lambda:legacy())
    excelButton = tk.Button(buttonFrame, text ="Convert json-formatted .txt files to Excel (Limited file size)", command=lambda:excel())
    binButton = tk.Button(buttonFrame, text="Convert .bin to .txt", command=lambda: binConvert())
    analysisButton = tk.Button(buttonFrame, text="File Analysis Functions (WIP)", command=lambda:analyze())
    updateButtons()

def runUpdater():
    #create update thread
    updateThread = threading.Thread(target = Updater.DataTranslatorUpdater.runUpdater, args = ())
    #destroy the root page
    root.destroy()
    #start the thread
    updateThread.start()


def openHowTo():
    #find the HomeScreen.txt file]
    howToFilePath = "Guides/HomeScreen.txt"
    #open the howToFile file in notepade (See if this works on mac.....)
    if sys.platform.startswith("win"):  # Windows
        os.system(f'notepad.exe {howToFilePath}')
    elif sys.platform.startswith("darwin"):  # Mac
        os.system(f'open {howToFilePath}')

def settings():
    settingsPath = "Settings/Settings.csv"
    #open the howToFile file in notepade (See if this works on mac.....)
    if sys.platform.startswith("win"):  # Windows
        os.system(f'notepad.exe {settingsPath}')
    elif sys.platform.startswith("darwin"):  # Mac
        os.system(f'open {settingsPath}')

#pack the main page
frame = tk.Frame(root)
frame.pack(pady=20)

# Create main label
programSelectLabel = tk.Label(frame, text="Please choose a program/tool")
programSelectLabel.pack()

# Create frame for buttons
buttonFrame = tk.Frame(root)
buttonFrame.pack(pady=20)

#create the dataProcessingToolButton
dataProcessingToolButton = tk.Button(buttonFrame, text="    Data Tool    ",font=("Helvetica", 14, "bold"), command=lambda: dataProcessingTool())
dataProcessingToolButton.grid(row=1, column=0, padx=20)

# Create button 2
updaterButton = tk.Button(buttonFrame, text="Update Program", command=lambda: runUpdater())
updaterButton.grid(row=1, column=4, padx=20)

# Create Button 3
howToButton = tk.Button(buttonFrame, text="How To", command=lambda: openHowTo())
howToButton.grid(row=1, column=5, padx=20)

#Create button 4
settingsButton = tk.Button(buttonFrame, text="View/Edit Settings", command=lambda: settings())
settingsButton.grid(row=1, column=6,padx=20)

# Run the application
root.mainloop()
