Georgia-Tech-Off-Road/GTOR-DAQ/(commit log)

2024-10-09 Create Torque Sensor
2024-10-09 Create Hall Effect Sensor
2024-10-25 Create Wire Color Legend
2024-10-27 Strain gauge, more documentation stuff
    [Strain_Gauges_BoM.xlsx]
2024-10-29 update some folders
    [Config.txt]
2024-10-29 updated config
    [Config.txt]
2024-10-29 Andrew is picky
    [Config.txt]
2024-10-30 not big numbers (oopsie)
    [Config.txt]
2024-10-30 Further streamlined download process
    [Config.txt]
2024-11-04 Fixed Data Translator!
    [Config.txt]
2024-11-06 Added brake pressure library
2024-11-13 minor updates
    [2024-10-26 15_3_29Config.txt]
2024-11-17 fixed vairableNames and added a bunch of comments
    [Config.txt]
2024-11-17 deleetd random things
    [2024-10-26 15_3_29Config.txt, Config.txt]
2024-11-17 deleted uneccessary config file
    [2024-10-26 15_3_29Config.txt]
2024-11-18 added how to guides
    [Config.txt]
2024-11-20 added documentation!
    [2024-10-26 15_3_29Config.txt]
2025-01-13 added a couple debugging things
2025-01-18 ADCS ARE WORKING!
    I got an ADS1115 ADC to work with the aux daq. It uses interupts to alert the teensy to when data is ready which is then collected and saved in an array of analog values. These values are then pasted into the output file
2025-01-19 BNO05 Added
    Got the BNO05 working on a seperate i2c bus but its slow now :(:(:(
2025-01-20 Updated a lot (see notes)
    Changed aux daq code to save data to a construct and write that as binary to the SD card. This file must be unpacked with BinFileTranslator.py before being operated on by our preexisting programs. NOTE BinFileTranslator.py is a quick and dirty program made by chatgpt. It should be updated and incorporated into the data translator tool somehow.
    [2024-10-26 15_3_29Config.txt]
2025-01-20 cleaned some stuff up and flipped the order of analog and digital vlaues
    [BinFileTranslator.py, DaqPackCode.ino]
2025-01-20 added second BNO05 sensor
2025-01-24 Update Wire Color Legend
2025-01-24 Create pressure line graph thing
    Create pressure line graph thing in 7 Data Translation
2025-01-25 Create config.txt
    Create config.txt in data translation
    [config.txt]
2025-01-25 Added pressure line graph
    Added pressure line graph
2025-01-25 Revert "Create pressure line graph thing"
2025-01-27 Changes to visualizations after testing day
    Changes to visualizations after testing day
    [config.txt]
2025-01-27 Fixed some stuff and added a progress bar!
    [2025-1-25 10_0_12.binConfig.txt, 2025-1-25 10_0_12Config.txt, 2025-1-25 14_49_2.binConfig.txt]
2025-01-27 deleted some configs
    [2025-1-25 10_0_12.binConfig.txt, 2025-1-25 10_0_12Config.txt, 2025-1-25 14_49_2.binConfig.txt]
2025-01-29 No changes
    No changes
    [2025-1-25 13_44_40Config.txt]
2025-01-30 QOL chnges
    QOL changes
    [2025-1-28 22_8_4Config.txt]
2025-01-31 Attempt to find weird outliers in brake pressure
    Attempt to find weird outliers in brake pressure
    [Test2.txt.csvConfig.txt]
2025-02-06 Implemented Config File Reader
    Created a function to read the .config file and create an array of initialized sensors from the file.
2025-02-09 Added option for default config
    Added option for default config
    [defaultConfig.txt]
2025-02-09 Polymorphism work
    Working on Sensor Polymophism, differences in analog and digital sensor data processing.
    [TestConfig.txt]
2025-02-12 Convert function
    Work on paring convert function with function names
    [TestConfig.txt]
2025-02-12 Added Hive Mind 1
    [AUX DAQ.SchDoc, Aux Daq Board - Simplified.PrjPcb, Inputs.SchDoc]
2025-02-19 Writing to Output File
    Added code to write translated data to output.csv file.
    [defaultConfig.txt]
2025-02-19 NOT WORKING RIGHT
    NOT WORKING RIGHT
    [2025-1-25 10_0_12Config.txt, Settings.csv]
2025-02-21 Testing w/ andrew
    Testing w/ andrew
    [2025-1-25 13_44_40Config.txt]
2025-02-21 NEW DATA TRANSLATION WORKING!!!!
    NEW DATA TRANSLATION WORKING!!!!
    [output.csv]
2025-02-23 Fixed settings
    Fixed settings
    [Settings.csv, output.csv]
2025-02-23 Made this mech e friendly
    Made this mech e friendly
    [Settings.csv]
2025-02-24 Data downloader changes
    Data downloader changes
    [Settings.csv]
2025-02-24 Refined column sensor mismatch error message thrown
2025-02-26 Update buttons removed from dAQ.py
    Update buttons removed from dAQ.py
2025-02-26 small changes
    small changes
    [2025-1-25 13_44_40Config.txt]
2025-02-27 Rotary Sensor Test
2025-02-27 Rotary Encoder Updatye!
2025-03-05 Adjusted code for use with bno IMU
2025-03-05 Create Excel for optim.
    Create Excel for optim.
    [Sensor Bits per Second Optimizing.xlsx]
2025-03-05 Edited excel
    Edited excel
    [Sensor Bits per Second Optimizing.xlsx]
2025-03-05 Update Sensor Bits per Second Optimizing.xlsx
    [Sensor Bits per Second Optimizing.xlsx]
2025-03-05 Fixed i2c comms
2025-03-05 Massive Updates
    Compiled/Wrote a library to handle AMT22 readings with TeensyThreads and moved general program over to TeensyThreads. Seeing MASSIVE performance improvements due to this so far
2025-03-06 Added library for RPM Sensors
2025-03-07 Changed Config
    Added extra line on top of config file and corrected code accordingly
    [2025-1-25 10_0_12Config.txt, 2025-1-25 13_44_40Config.txt, 2025-1-28 22_8_4Config.txt, defaultConfig.txt]
2025-03-09 Excel changes
    Excel changes
    [Sensor Bits per Second Optimizing.xlsx]
2025-03-11 .
    .
    [Sensor Bits per Second Optimizing.xlsx]
2025-03-12 Integrating endian library with code
    Integrating boost endian library with code. Also working on fleshing out the SensorInfo struct for each Sensor.
2025-03-23 Redesigned SensorInfo struct
2025-03-23 Added millisec sensor to Sensors.h
2025-03-24 EncodeDecode changes Made SensorInfo constructor constexpr fleshed out encoding and decoding of packets
    Please enter the commit message for your changes. Lines starting
2025-03-26 Using Templated Metaprogramming For SensorData
2025-03-26 Created SensorIndices struct
    Created struct which can be used to store the different sensor indices. Working on template metaprogramming.
2025-03-28 Updated SensorInfo to be a fully static class
    Also millisec sensor
2025-03-28 Pain and Suffering
    [2025-1-25 10_0_12Config.txt, 2025-1-25 13_44_40Config.txt, 2025-1-28 22_8_4Config.txt]
2025-03-28 Transitioned SensorData to template metaprogramming approach
    Implemented basics
2025-03-28 Removed digital sensor options from DAQSensor.cpp
    Updated millisec sensor to copy data directly from .txt to .csv (processing will now be done on-board)
2025-03-30 Added elem getters and setter to SensorData.h
2025-03-30 Finally got SensorData::getData<>() to work!
2025-04-01 Removed PacketEncode code, will implement in SensorData
    cleaned up getData, setData, etc.
2025-04-01 Templated SensorData::encodeData
    Created function to encode data inside SensorData.h
2025-04-02 Revert "Fixed merge issues"
    Accidentally developed for EmergencyDAQ branch in AuxDAQ
    This reverts commit 8c3cd3a101eb9675d2a57d368c3c400fb1071da5.
    [AMT22.cpp, AMT22.h, DaqPack.h, DaqPackCode.ino]
2025-04-02 Created runtimeEncode function() in SensorData
2025-04-02 Created sensorEncodeSizeTable
    Created array to access ENCODED_BIT_SIZE information from SensorInfo type at runtime
2025-04-04 Added brake tester file
2025-04-04 Create CVTTempSensor.h
    Added library for CVT Temp Sensor
2025-04-05 Testing day
    Testing day
    [defaultConfig.txt]
2025-04-06 Created encodePacket() and decodePacket() inside SensorData
2025-04-07 Added defaultEncode(), defaultDecode(), and defaultConvert() functions in SensorInfo
2025-04-08 Added clutch engaged and pit requested sensor infos
2025-04-09 t
    t
    [Settings.csv]
2025-04-09 Working on speed sensor
2025-04-09 4/8/25 test visualizer changes
    4/8/25 test visualizer changes
    [TestConfig.txt, defaultConfig.txt]
2025-04-11 Speed and position sensor implemented. Documentation changes
    Finished speed sensor info and created position sensor info based off of the speed sensor.
    Added better documentation to SensorInfo
2025-04-11 Documentation changes to SensorData.h
    Added documentation to getData(), getRefToData(), getConstRefToData(), and setData()
2025-04-11 Added brake pressure sensor info
2025-04-11 Updated SensorInfoTuple in AllSensors.h
2025-04-11 Created DAQInfrastructure unit tests
    Created unit tests to test DAQ's specific implementation of the framework created
2025-04-11 Created floatEncode() and floatDecode(). RPM Sensor added.
2025-04-11 Added linear acceleration and CVT temp sensor infos
2025-04-11 Added forgotten files
    Added all Sensor.h files, and DAQInfrastructure_unittest.cpp
2025-04-15 Post testing day changes
    Post testing day changes
    [defaultConfig.txt]
2025-04-16 Created convertData() function of SensorData
2025-04-16 Float tranmission and cleanup
    Added floatEncode() and floatDecode() in SensorInfo.h. Removed CMakeCache.txt and Makefiles from being tracked.
2025-04-16 Added JSON Serialisation Methods to SensorData
2025-04-17 Added serializeToJSON for sensors
    Added serializeToJSON for millisec, clutch_engaged, and pit_requested sensors. Also enhanced DefaultBoolSensor<> and added DefaultSensor<> templates
2025-04-18 Added linear_acceleration, RPM, and steering_rotation serialize to JSON
2025-04-18 Redid file organization
    Added DAQInfrastructure folder for DAQ implementation of framework
2025-04-18 Improved documentation SensorData.h
    Improved documentation of public methods in SensorData.h
2025-04-18 Refactored Brake Pressure Sensor
2025-04-18 Implemeneted serializeToJSON for all sensors
2025-05-01 Updated Brake Pressure Calculations
2025-05-01 Updated Config Files
    [2025-4-30 Config.txt]
2025-05-01 Fixed Transfer Case Problems
    [2025-4-30 Config.txt, defaultConfig.txt]
2025-05-03 Updated defaultConfig for new setup
    [defaultConfig.txt]
2025-06-23 Added Stages section to SoftwareProposal.md
    Added a section in the software proposal form to plan out projects for
    the software.
2025-06-30 Reorganized Repo Directory Structure
    Moved '8 Libraries' to '00 Libraries' (In accordance with new development guidelines). Renamed all folders to have a two digit starting code instead of one (i.e '7 Data Translation -> '07 Data Translation')
    [GTOR Inventory.xlsm, Sensor Bits per Second Optimizing.xlsx, Settings.csv, Strain_Gauges_BoM.xlsx, Ziptie_2.15.STL, defaultConfig.txt, loopback.perf_board.4.0.fzz, loopback.perf_board.4.1.fzz]
2025-08-11 Modifed Code for BinaryBuffer submodule
    Modified current code to work with BinaryBuffer submodule modifications
    to work with Arduino.
2025-08-18 Updated CommboardTransmissionLibrary
    Now Arduino compatible
2025-09-02 Updated CMBTL Sensor Implementation
2025-09-05 Refactored libraries
    Moved libraries around to make it easier to share arduino code work.
2025-09-05 Stage 1: Removed Old Binary Buffer Folder
2025-09-05 Stage 2: Updated Binary Buffer location
2025-09-05 Deleted old and moved libraries
    Deleted old and moved libraries from '00 Libraries'/. Arduino libraries
    should now be stored in "Arduino Libraries"/libraries/
    [loopback.perf_board.4.0.fzz, loopback.perf_board.4.1.fzz, serialconfig.txt]
2025-09-05 Stage 1: Removed Old BoostForArduino files
2025-09-05 Stage 2: Moved Boost For Arduino
2025-09-05 Stage 1: Deleted old CommboardTransmissionLibrary files
2025-09-05 Stage 2: Updated CommboardTransmissionLibrary location
2025-09-08 Code Update
    I attempted to change the polling logic to save via interrupts but I'm
    currently failing to get files to create/save. Going to revert to
    previous known good point for further diagnosis.
    [DaqPackCode.ino]
2025-09-08 Fixed the File Save
    Deleted some serial prints and changed the pin assignments to allow for
    proper saving on the Green Machine PCBS.
    [DaqPackCode.ino]
2025-09-08 Finished Space Concious Data Collection Upgrade
    I got the code from earlier working and tested with a generated file.
    Average polling rate was 62.9 with expected polling rate of about 64.
    This discrepancy could very likely be due to the ADS or some other,
    non-code related issue, but we should monitor this for the future.
    p-Variance was incredibly low at 0.09
    [BinFileTranslator.py, DaqPackCode.ino]
2025-09-10 DaqPack.h conversion to CMBTL_DAQInfrastructure
    Converted code in DaqPack.h to use Sensor suite setup in
    CMBTL_DAQInfrastructure
2025-09-10 Updated CMBTL_DAQInfrastructure
    Updated library to add teensy temp sensor
2025-09-12 Fixed c_str bug in DaqPackCode.ino
    [DaqPackCode.ino]
2025-09-12 Consolidated Teeth Ammount for DaqPack.h
    Made a macro for the number of teeth for our RPM sensors
2025-09-14 Updated to Mostly Work
    Still having some potential problems with file saving but seems to be
    working better. Potentially fixed the autosave code and added debugging
    outputs to the file creation method. DAQ.py needs to be updated to
    accomodate new JSON format.
    [DaqPack.h, DaqPackCode.ino]
2025-09-17 Avg button
2025-09-17 Updated DAQ Pack Code
    Made better, fixed JSON stuff, tested to validate RPM, much gamur
    [DaqPack.h, DaqPackCode.ino]
2025-09-20 Added a couple more files
    Added some files for when stuff be jank
2025-09-24 Updated daq pack code
    oops! wrong branch
    [DaqPack.h, DaqPackCode.ino]
2025-09-24 Created a button for prGraph
2025-09-24 Created a project
    Created an altium project and saved it to the DAQBOXRev12025 folder in
    the 11 CAD folder on github. New members will be using this folder to
    work on the CAD.
    [DAQBOXRev12025.PrjPcb, MainSchematic.SchDoc]
2025-10-01 Changed PCB Schematic
    [PCB2.PcbDoc, Schematic.SchDoc]
2025-10-08 Made a ton of edits am tired
    Added ADC and requisit hardware
    new file: 11 CAD/DAQBOXRev12025/History/PCB2.~(3).PcbDoc.Zip
    [PCB2.PcbDoc, Schematic.SchDoc]
2025-10-08 epic gamur
    [Schematic.SchDoc]
2025-10-08 Added a bunch of debugs
    Changed the clock oscillator, added a ton of debug ports, and added
    hookups for SPI, I2C, CAN, and UART, also added through holes for
    mounting
    [DAQBOXRev12025.PrjPcb, DebugOutputs.SchDoc, MainSchematic.SchDoc, Schematic.SchDoc]
2025-10-09 Just about finalized design!
    Went in and handled a bunch of design rule violations, I think the ones
    that are left can be ignored
    [DAQBOXRev12025.PrjPcb, MainSchematic.SchDoc]
2025-10-10 Added old DAQPack code for reference
    Older DAQPack code contained useful teensy threading implementation that
    was accidentally overwritten during code simplification without saving.
2025-10-15 Replaced LDSOne with frontBrakePressureSensor
    [DaqPackCode.ino]
2025-10-21 Updated DAQ Pack Code
    It won't work until CMBTL is updated but yeah. Also some minor changes
    to radio config files, updated to the load cell sled pull code etc etc
    [DaqPack.h, DaqPackCode.ino, LoadCellCode.ino]
2025-10-21 Auto-merging 00 Libraries/Arduino Libraries/libraries/ADS1256-main/examples/ADS1256-Example/ADS1256-Example.ino CONFLICT (content): Merge conflict in 00 Libraries/Arduino Libraries/libraries/ADS1256-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
2025-10-30 Added LDS Calibration and Updated Formula
    Added LDS calibration functionality and updated the linear analog sensor
    formula to add minimum value to the end of the computed percentage of
    range. (Basically fixed a derp)
    [DaqPack.h, DaqPackCode.ino]
2025-10-31 Add VariableRGBLED sketch under 04 Sensors
    [Settings.csv]
2025-10-31 Added second ADC and updated cmbtl
2025-10-31 Pushed a default settings config
    Updated DAQ.py doesn't launch without a Settings/settings.csv existing
    so I downloaded the one from Joseph's branch and force added it to
    overide the .gitignore file. Should be working now!
    [Settings.csv]
2025-11-02 Updates to CommboardTransmissionLibrary
    Made updates to CommboardTransmission library to prepare for integrating
    binary encoding into Arduino. For more details, see commit message in
    CommboardTranssmisionLibrary submodule.
2025-11-03 Added switch for json/binary
2025-11-05 Updated to use better micros()
    Changed code to use an intervalTimer to generate microsecond value.
    Incremeneted every 5 microseconds with a higher priority level than the
    attachInterrupt based things we have
2025-11-05 Changed save logic to be interrupt/flag triggered
    Preserved debounce functionality
2025-11-09 Looks like I changed half a million files but thats because I had to pull from my corrupted windows laptop so they're really mostly the same. CUDA functionality should be added tho!
    [2025-10-31 23_12_39Config.txt, Settings.csv, defaultConfig.txt]
2025-11-09 Removed some massive data files from the push
    [2025-10-31 23_12_39Config.txt]
2025-11-09 Changed some resolutions and fixed the cuda module name for cuda compilation
    [DAQ.py]
2025-11-10 First attempt, havent tested yet. Doesn't allow filename/directory to be set yet
    [DAQ.py]
2025-11-11 Refined file saving, fixed some window size problems, made the program run sys.exit(0) (kill the process) when the main window closes, made opening data tool hide the main page, and made closing data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
    [DAQ.py]
2025-11-12 Added RPM Spike Filter
2025-11-19 Copied the folder from the branch that had the newest pcb stuff on it. Sorry about the force push again everyone
    [DAQBOXRev12025.PrjPcb, MainSchematic.SchDoc, Sheet1.SchDoc]
2025-11-19 Fixed old code and DAQ_AMT22 to actually use the threading library delay. Also commented out the RPM code to be able to focus on thread stuff
    [DaqPackCode.ino]
2025-11-19 Made a threaded DAQ_HX711 library
2025-11-21 Updated Sensor positions
2025-11-21 fixed file write (I think)
    [DaqPackCode.ino]
2025-12-03 CAMtastic NC Drill Files added to Project Outputs
    [PCB2.GBL, PCB2.GBO, PCB2.GBP, PCB2.GBS, PCB2.GTL, PCB2.GTO, PCB2.GTP, PCB2.GTS]
2025-12-05 Delete 04 Sensors/Engine Dyno/.~lock.2025-12-04_20-41-14.csv#
    deleetd a random file
2025-12-05 Trying again, broken code for installer and restructuring for Applications
    [Settings.csv, defaultConfig.txt]
2025-12-07 12/7 changes to Low Pass Filter
    [DAQBOXRev12025.PrjPcb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]
2025-12-08 made more modular
    [additionalBuildingParameters.txt]
2026-01-21 Added SDTestWrite Program
    Took program from
    [here](https://docs.arduino.cc/learn/programming/sd-guide/), modified
    couple of lines to use correct SD card port.
    [SDTestWrite.ino]
2026-02-19 Added new sensor configuration
2026-02-19 Overhaul of Teensy Recording
    Now using a timestamp, single value packet recording system
2026-03-10 Add recursive SD card file transfer for Teensy
2026-03-11 Added DAQBoxRev22026
    [DAQBOXRev2.2026.PrjPcb, DebugOutputs.2.SchDoc, Filters.2.SchDoc, MainSchematic.2.SchDoc]
2026-03-11 Added DAQBoxRev32026
    [DAQBOXRev3.2026.PrjPcb, DebugOutputs.3.SchDoc, Filters.3.SchDoc, MainSchematic.3.SchDoc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]
2026-04-03 Added status LED code
    - Added code that uses the status for different lights
2026-04-07 Updated Code for new ADC
2026-04-07 Fixed ADC signals
2026-04-08 Added blockForButtonHold()
    - Waits for a button to be held down for some period of time
    - Uses debouncing logic to prevent noisy values from messing with the
    button hold
    [DaqPack.h, DaqPackCode.ino]
2026-04-10 Made DAQPackCode More User Friendly
    - Very nice screen
    - Verified that power/reset switch works correctly
    [DaqPack.h, DaqPackCode.ino]
2026-04-10 Updated DAQPackCode
    - Implemented configurable cut-off for RPM sensors
    - Much stricter interval cut-off for RPM sensors
    - Properly set ADC resolution (BIG DEAL!)
2026-04-11 Simplified DAQ LED Code
2026-04-15 Many Fixes
    - Fixed preemptive conversion of timestamp to 32 bits before divison.
    Should now have 5 days before overflow rather than 71 min
    - Added overflow detection in NewBinFileTranslator.py (in case we
    somehow need it)
    - Renamed auxRPM to rearRPM
    - Made button hold 3 sec rather than 1
    [DaqPack.h, DaqPackCode.ino]
2026-04-16 Updated RPM Sensors
2026-04-21 Updated for new LED lights
2026-04-24 LDS & RPM Code Update
    - Fixed RPM pins and conflict with DRDY (22) and 19 (some display pin)
    - We now record voltage only, not inches
    [DaqPack.h, DaqPackCode.ino]
2026-04-26 Printing raw hex values for ADS
2026-04-27 Potential Fix for LDS Code
    - Give ADS further time to calibrate
    - Prevent autorecalibration
2026-04-27 Refined ADC testing code
    - Use loops instead of trusting write register works
    - Debug print statements for FSC and OFC regs
2026-05-01 Moved to timeoutbased ADC reading
    - Timeouts if ADC cannot communicate fast enough over SPI
    - Previously waitForDRDYLow() might have taken forever
    - Added ADS1256 :: recover()
2026-05-02 Added Guard Value to Packet
    - Guard value protects packet in-case of SD card write errors, partial
    writes
    - Added RPM convolve program to run a convolution on the RPM timestamps
    [DaqPack.h, DaqPackCode.ino, Packet.h]
2026-10-22 Update rearandengineRPMcode.ino
    changed print interval from 250ms to 10ms per joseph demands
